pmonta/GNSS_Firehose/enclosure/README

The graphic overlays are in overlays.svg (editable with Inkscape).  Notes:

- designed for the Hammond 1455L1201 enclosure
- layers are provided for:
   * the drawn artwork (inkjet printer or color laser onto polyester self-adhesive media)
   * cut lines (robotic vinyl cutter)
   * bounding boxes
