pmonta/GNSS_Firehose/kicad/graphics/power-symbol.svg.png

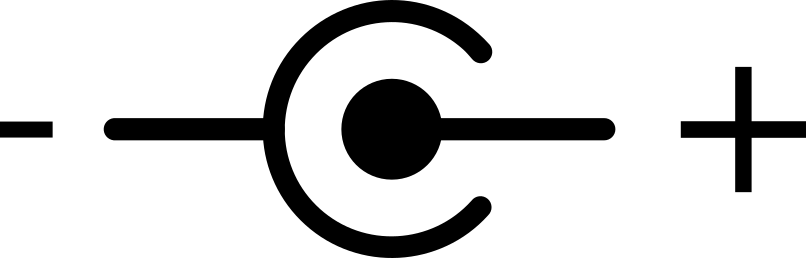
kicad/graphics/power-symbol.svg.png
