pmonta/GNSS_Firehose/enclosure/end_plate_front.step

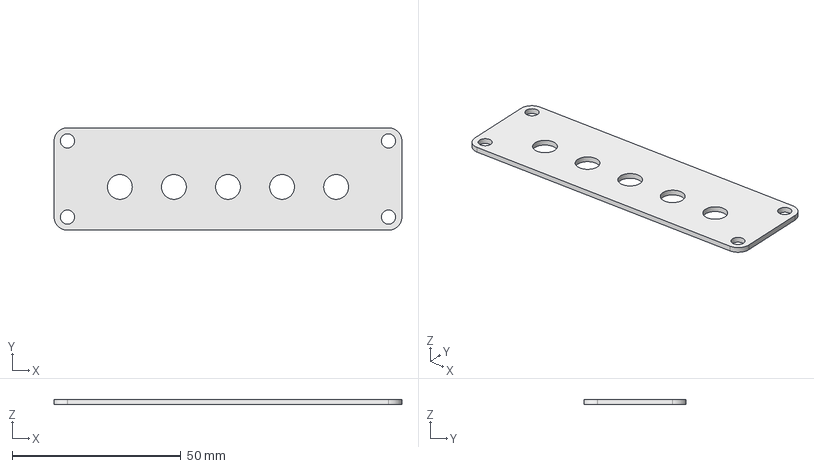
[picture p3: CAD file, 2015-06-21]
enclosure/end_plate_front.step
103.0 x 30.3 x 1.62 mm
