pmonta/GNSS_Firehose/enclosure/tcxo_cap.stl

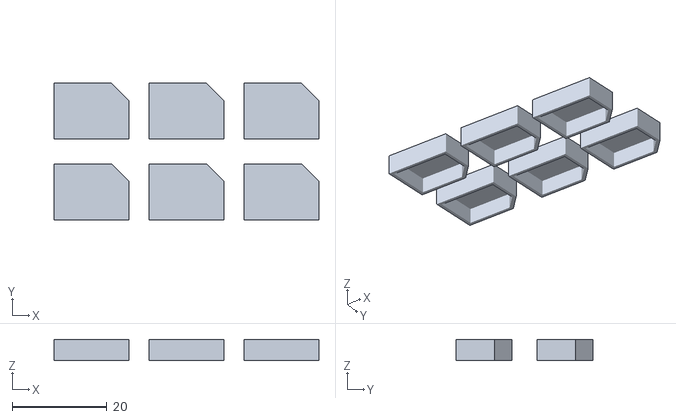
[picture p4: CAD file, 2015-06-09]
enclosure/tcxo_cap.stl
55.8 x 28.8 x 4.50
