pmonta/GNSS_Firehose/(list of files, cad)

Other CAD files:
enclosure/end_plate_back.fcstd
enclosure/end_plate_back.stl
enclosure/end_plate_front.fcstd
enclosure/end_plate_front.stl
