pmonta/GNSS_Firehose/(threads)

Thread 2 (2022-12-02):

AGC control algorithm

jr9910, 2022-12-02:
Hi, I want to know if there are some papers for the AGC control algorithm used in GNSS_Firehose

pmonta, 2022-12-07:
I didn't find too much in the literature about AGC specific to GNSS.  As with any AGC algorithm, it must not be too slow, since tracking some amount of dynamics in gain is desired (for example, temperature-dependent gain in the antenna's LNA, or variation in the Firehose's front-end gain blocks), but it also must not be too fast, to avoid nonlinearities resulting from artificially amplitude-modulating the desired signals.

The scheme in GNSS Firehose is very simple:  integrate a 2-bit histogram over some time interval (a few tens of milliseconds I think).  If the histogram is too narrow (relative to the ideal histogram of Gaussian noise optimally quantized to 2 bits), increase gain by a step, else decrease gain a step.  The steps are quite small, 0.02 dB or so.

If there's a better scheme, I'd be glad to hear about it.  I should probably write a quick "theory of operation" document with these sorts of details in it.  By the way, the Firehose's AGC can be disabled if desired, and a fixed gain applied instead.

Thread 4 (2024-01-29):

Mac M1 and M2 packets dropping

AgileEngineeringLLC, 2024-01-29:
Just a heads-up to others... My Linux boxes work just fine with the Firehose, but both my M1 and M2 macs drop ethernet packets randomly (shows up as IQ values of 0). Appears that the M1 and M2 macs have something wrong in their ethernet firmware or hardware.

pmonta, 2024-03-15:
Might there be options in the macOS networking stack or device drivers to help with this?  Back in the day I remember playing with things like the Linux driver's RX buffer size or interrupt threshold to decrease drops.  Everything has been reliable at default settings of late, though.

By the way, if the dropped packets are single packets only, then the dropout is likely too short in duration to affect the GNSS signal processing.  Large contiguous drops, though, of say more than 100 packets in a row, can start to be a problem.  Each packet's payload has a timestamp inserted by the FPGA, so the packet2wav tool knows when to fill in with zeros; this means the timing of the sample stream emitted by packet2wav is undisturbed by dropped packets, but of course the SNR decreases because of the lost signal.

AgileEngineeringLLC, 2024-03-15:
I researched online and found others having the same issue. I tried several different OS setting changes, but none worked for me. So i gave up trying to use the M2 Mac for recording. The dropped packets were pretty large blocks, and the dropouts occur regularly.
