pmonta/GNSS_Firehose/doc/GNSS_Firehose_schematic_monochrome.pdf

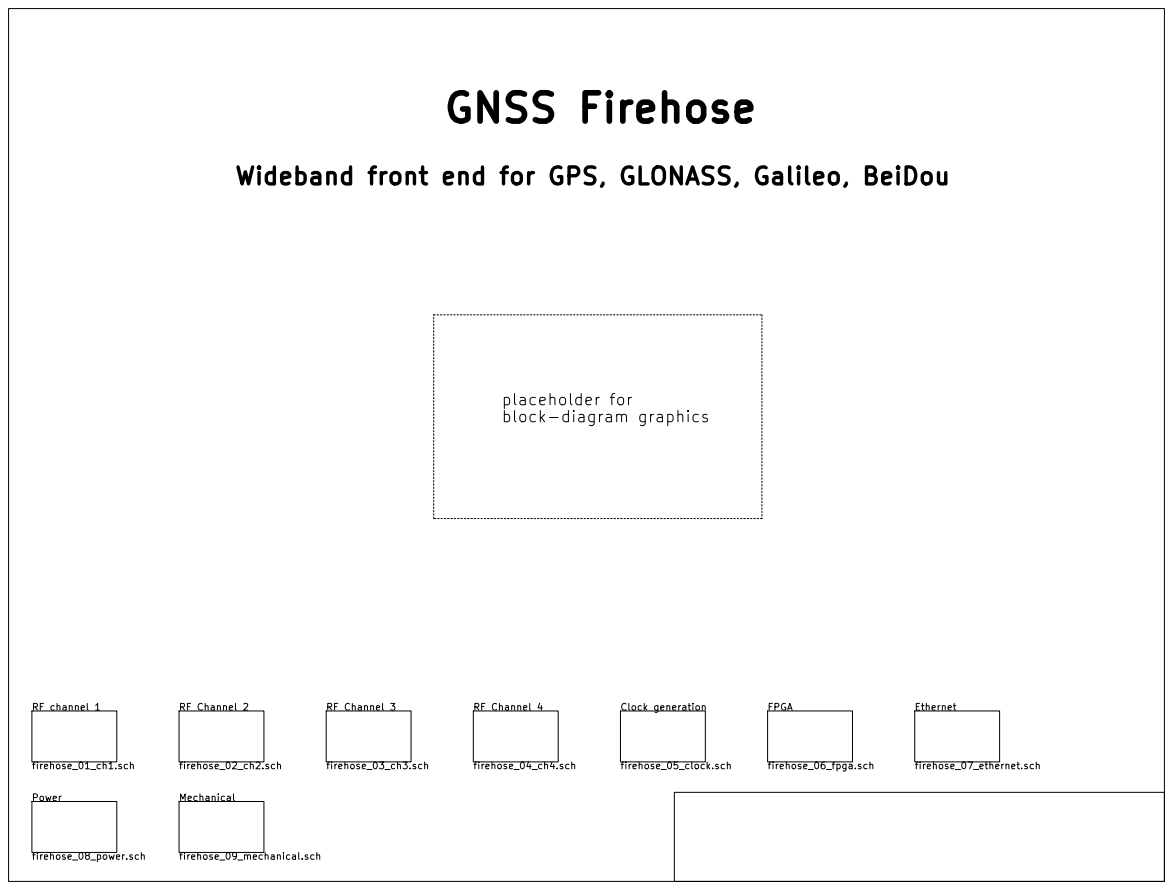
[picture p15: page 1]

Wideband front end for GPS, GLONASS, Galileo, BeiDou

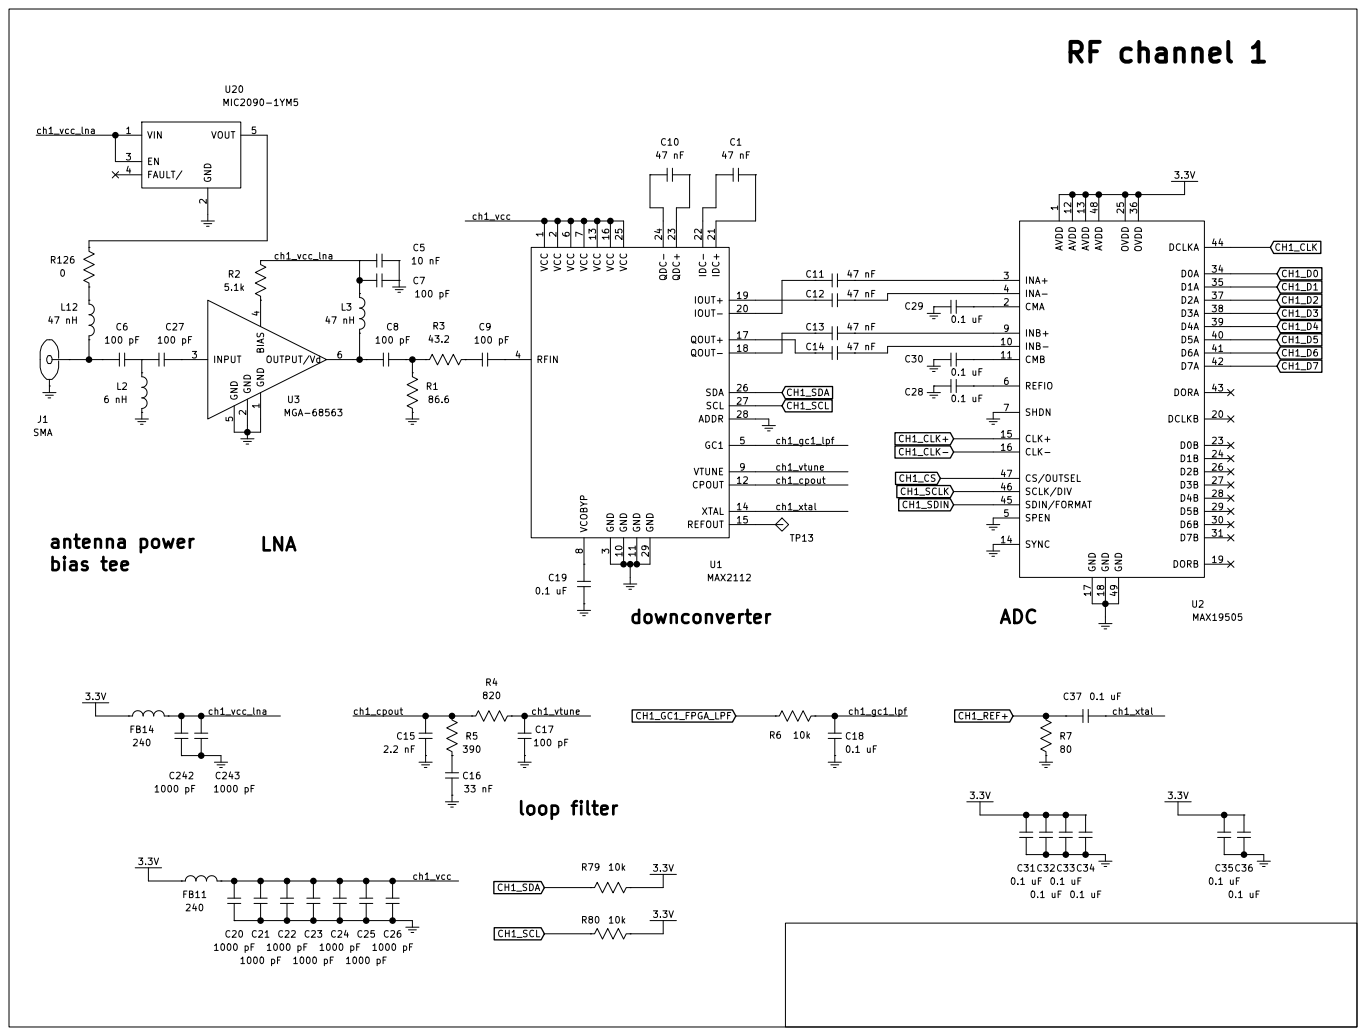
[picture p16: page 2]

5 OUTPUT/Vd 6 U3MGA-68563 RF channel 1
ch1_vcc_lna FB14

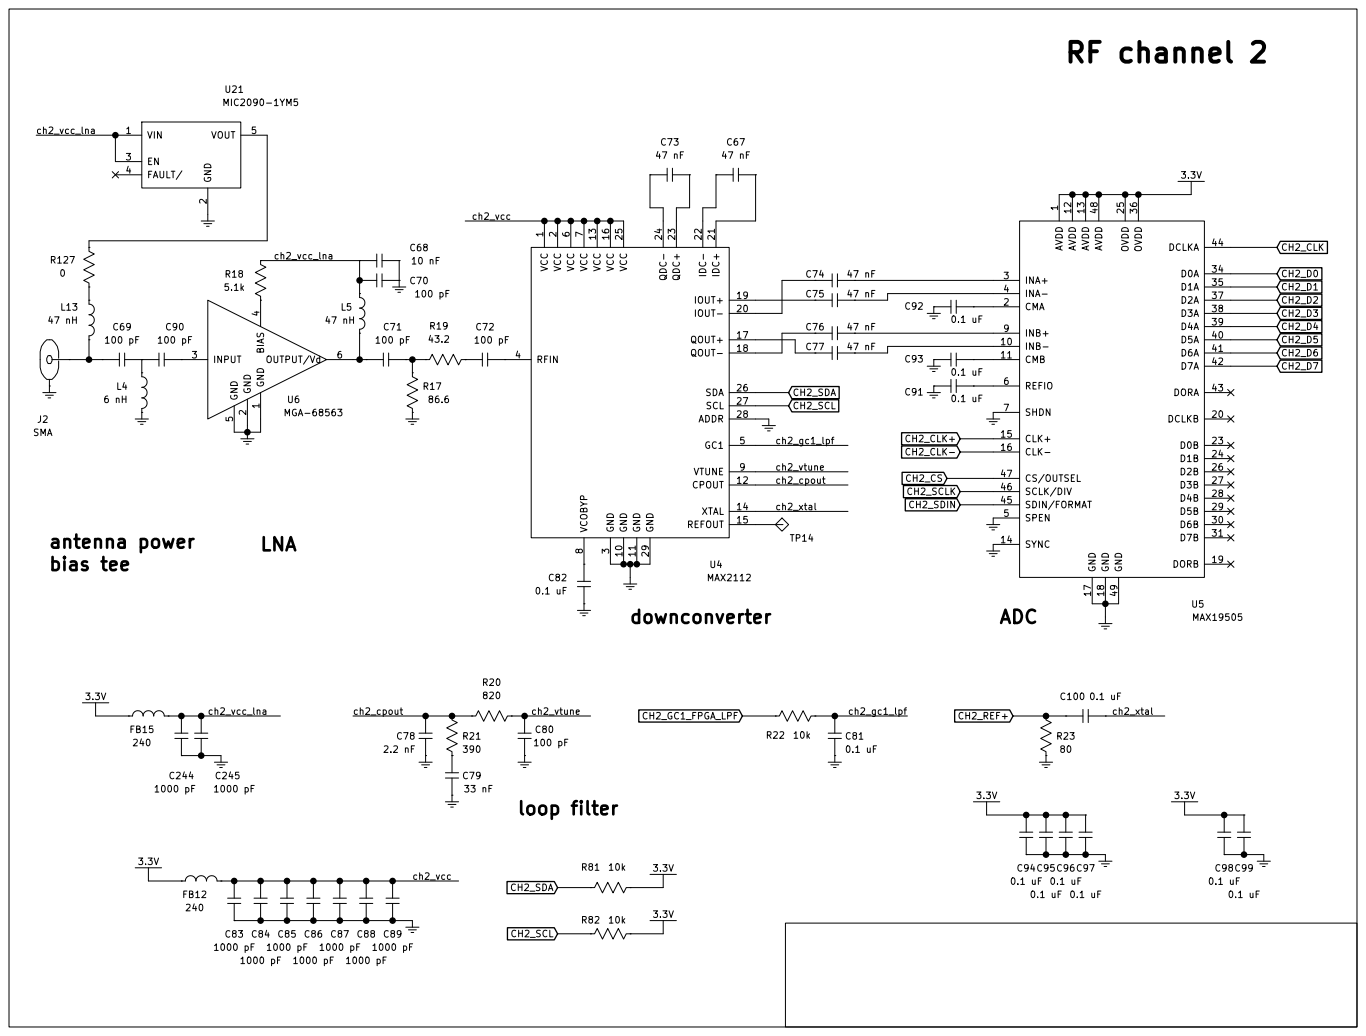
[picture p17: page 3]

5 OUTPUT/Vd 6 U6MGA-68563 RF channel 2
ch2_vcc_lna FB15

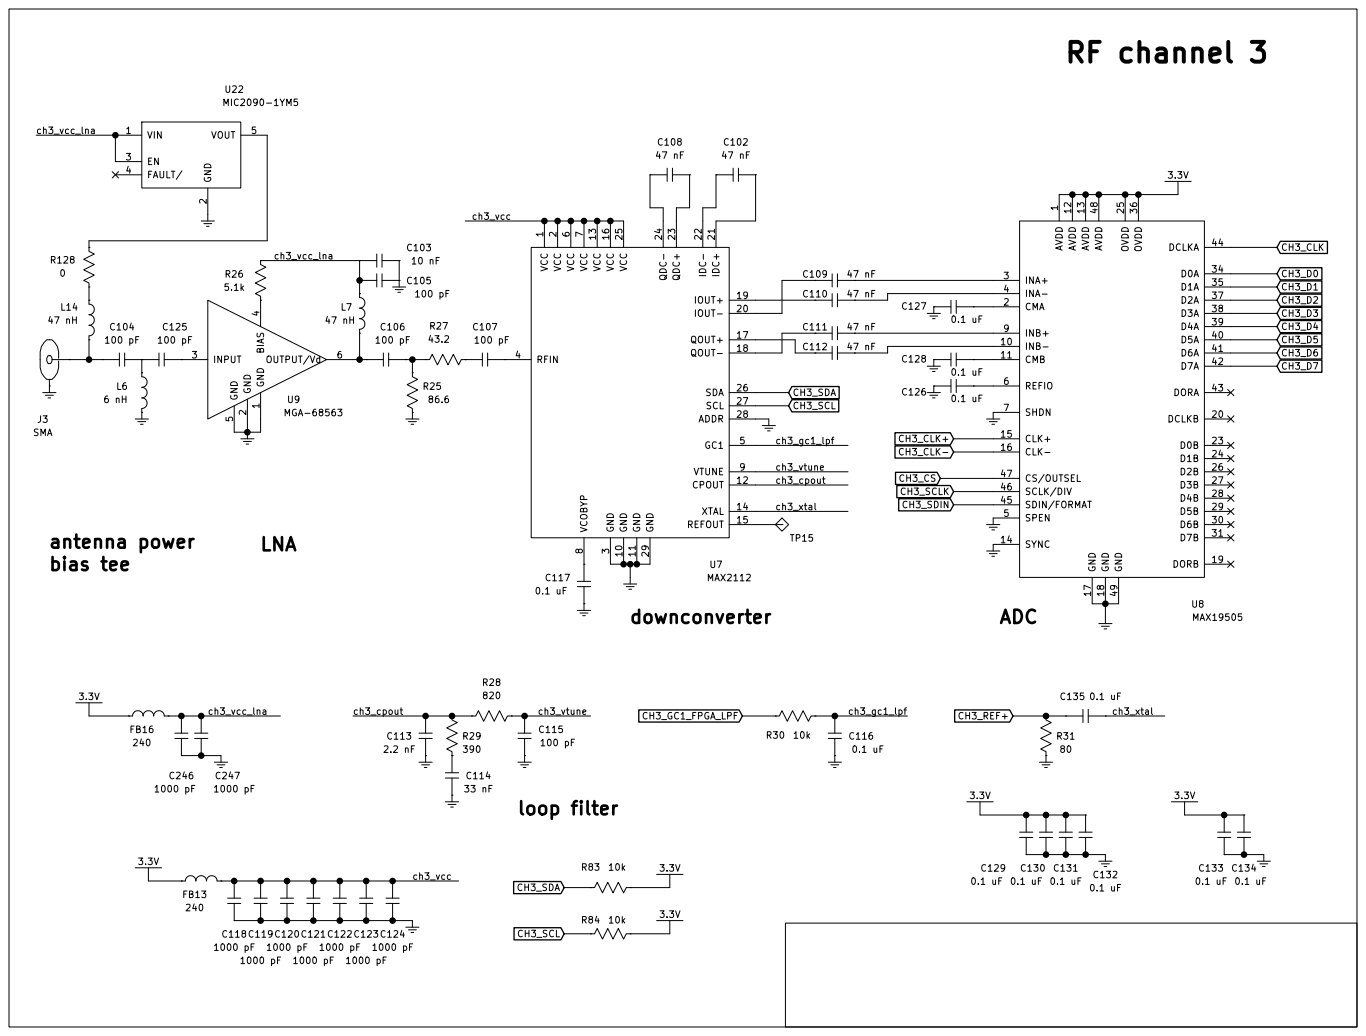
[picture p18: page 4]

5 OUTPUT/Vd 6 U9MGA-68563 RF channel 3
ch3_vcc_lna FB16

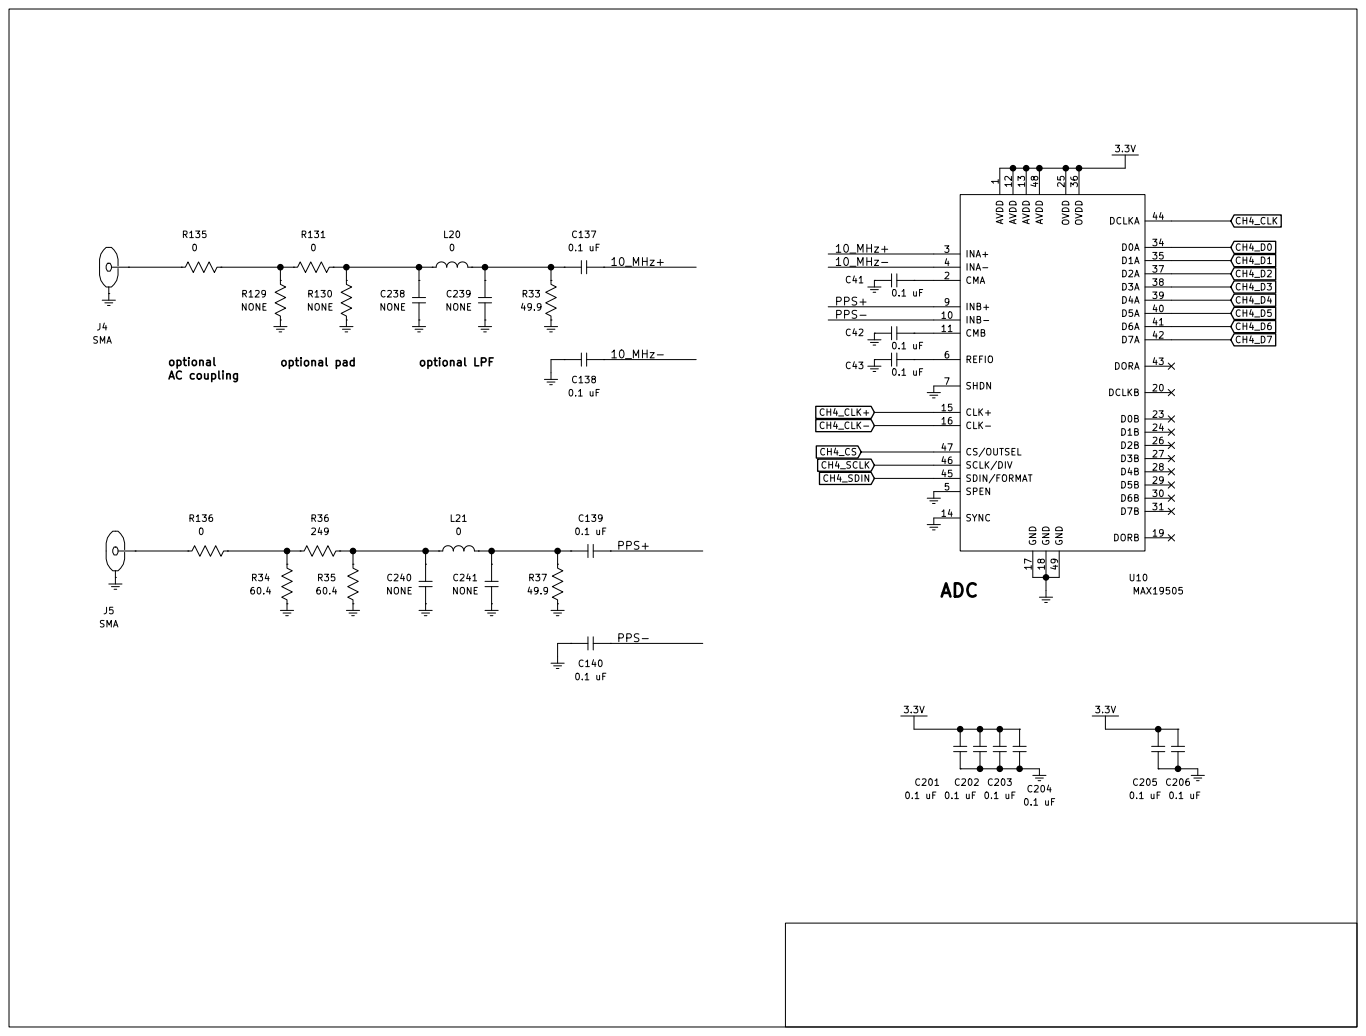
[picture p19: page 5]

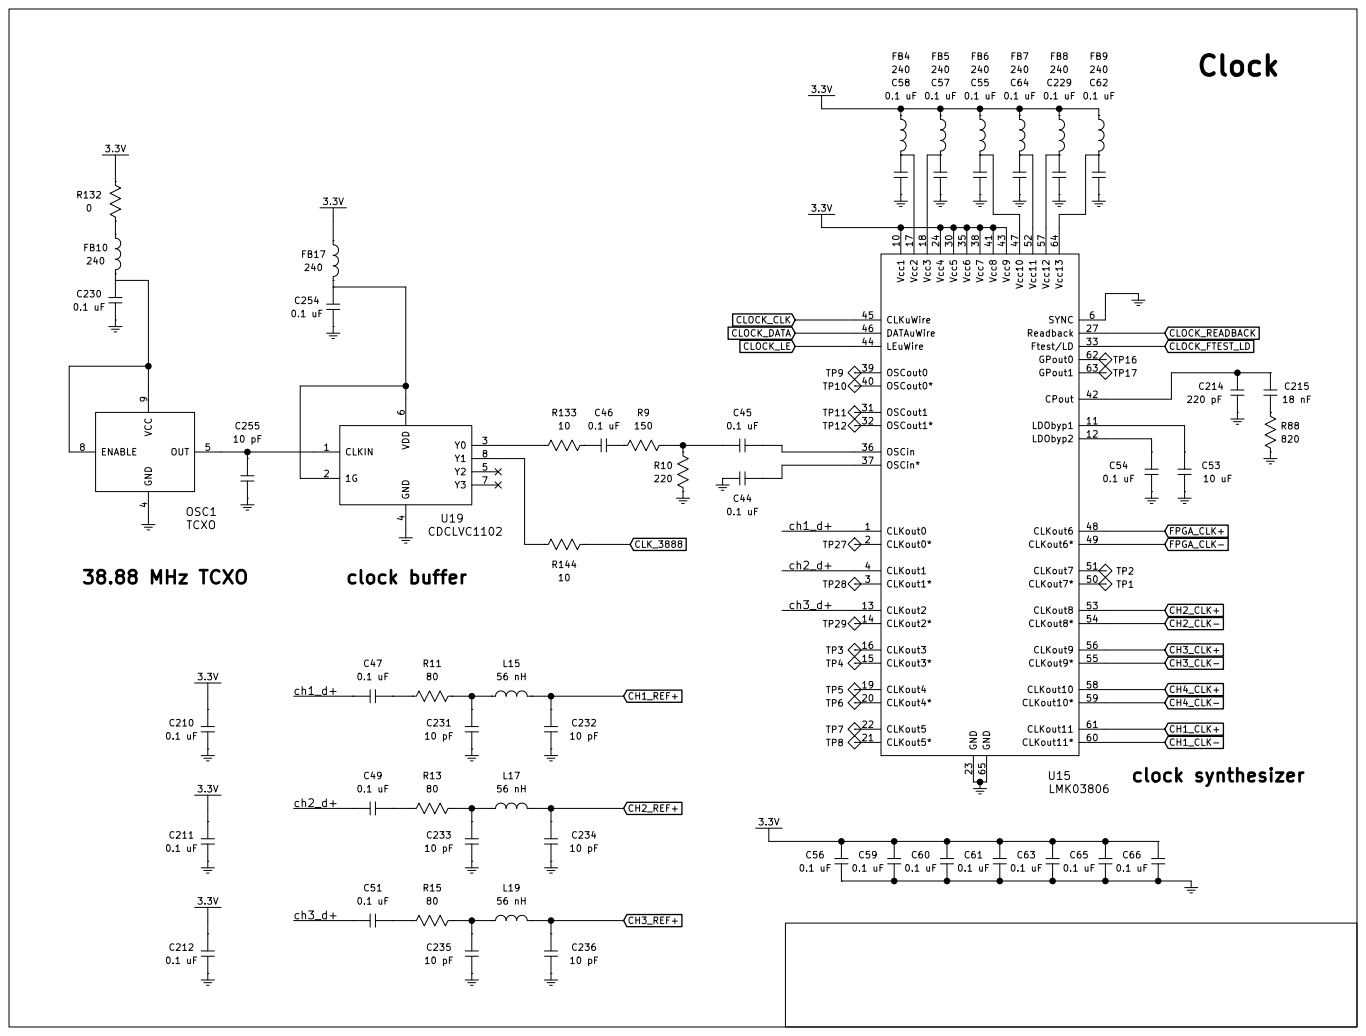
[picture p20: page 6]

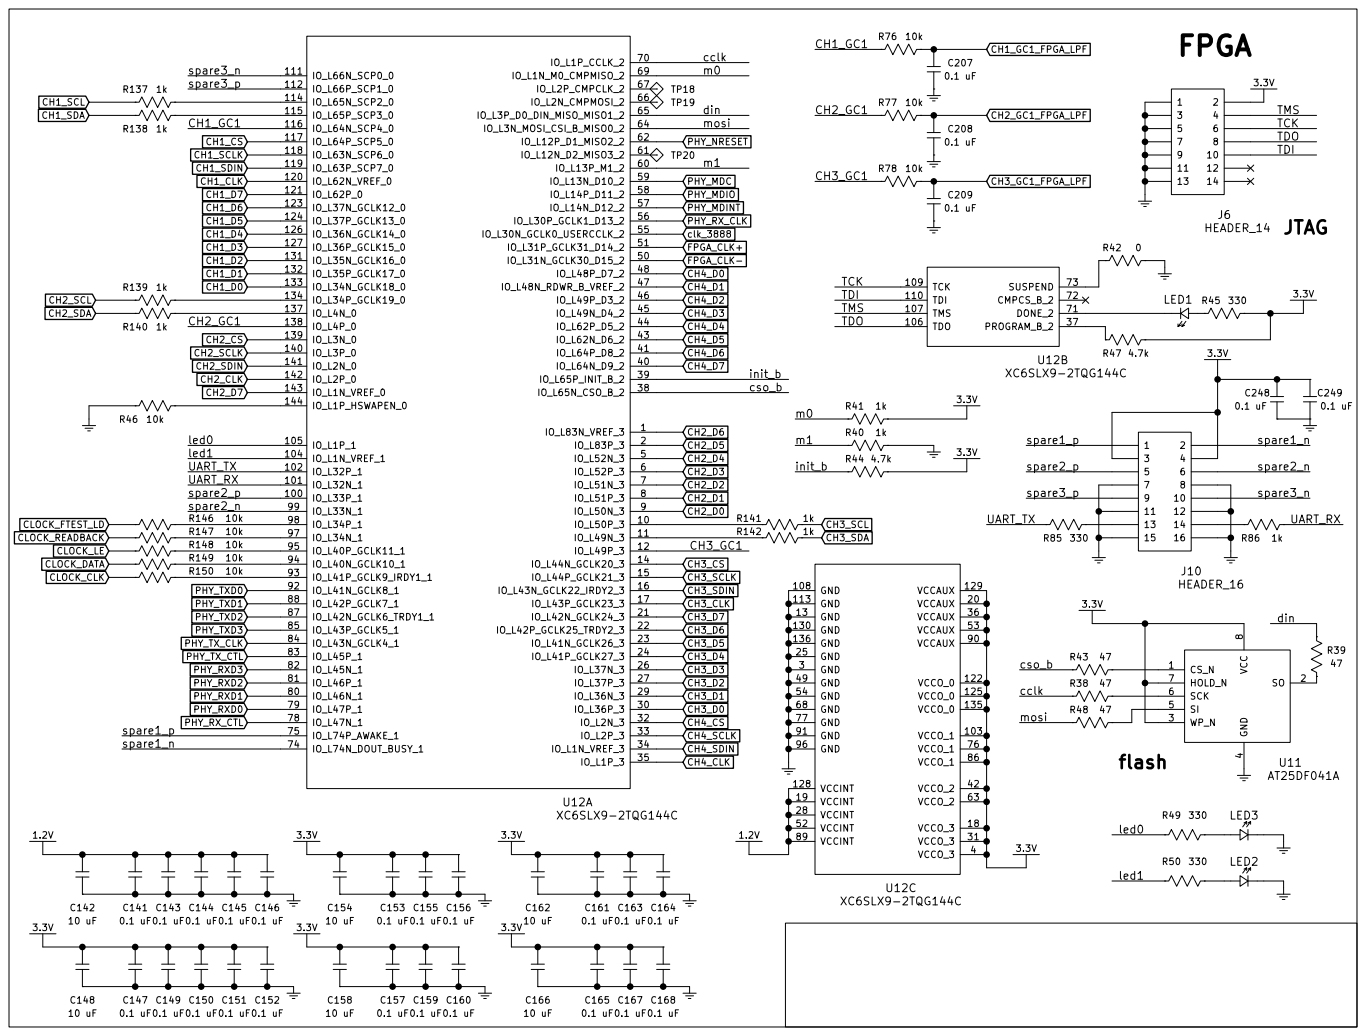
[picture p21: page 7]

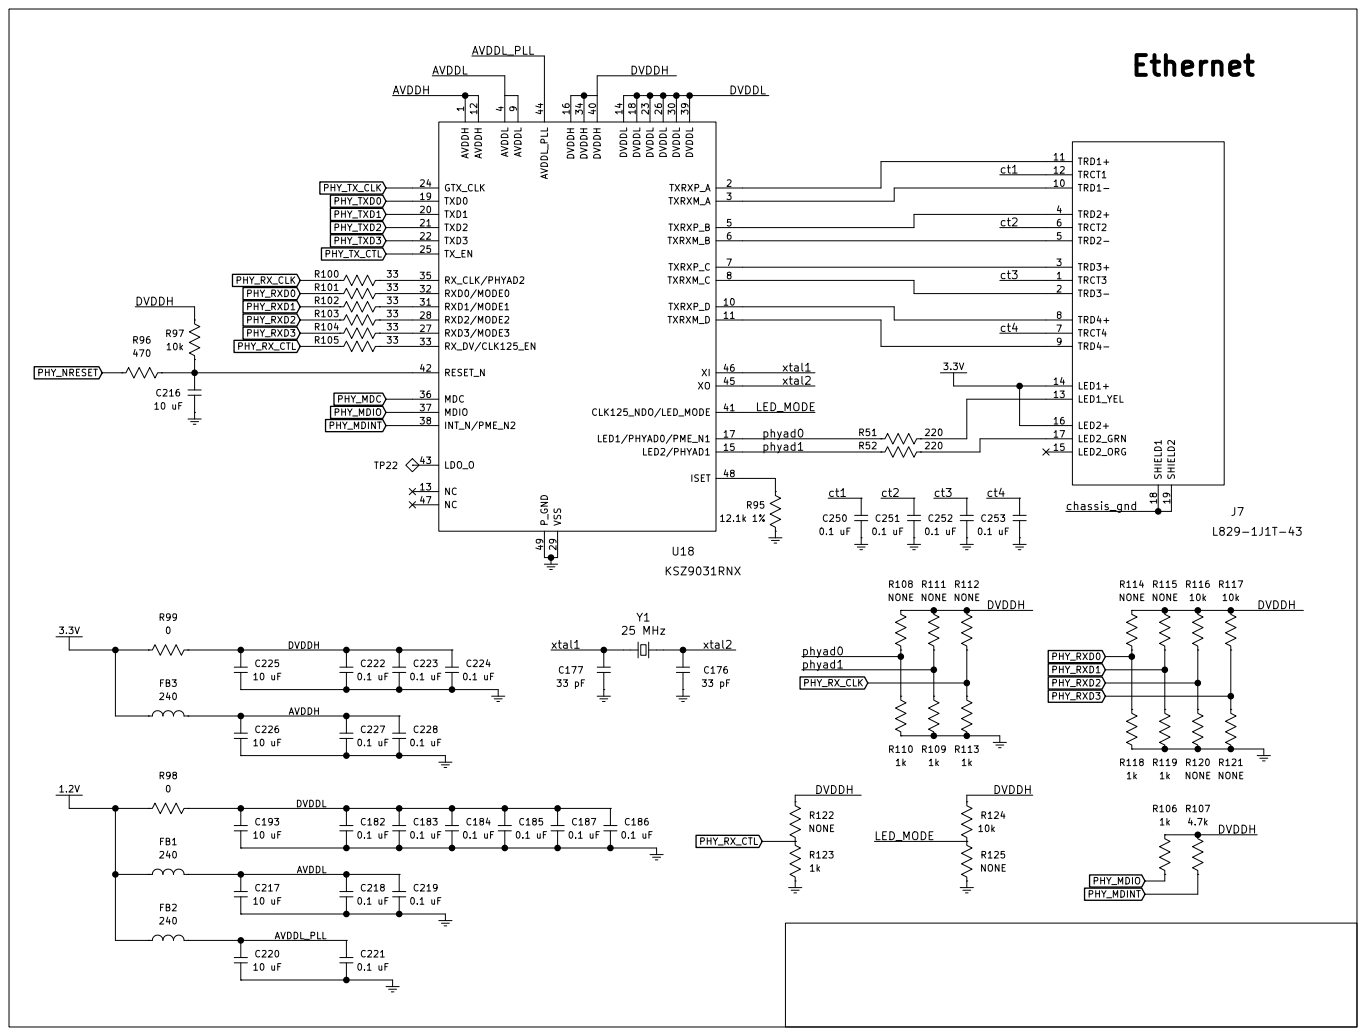
[picture p22: page 8]

9 TXRXP_D 10 TXD1 20 DVDDL 30 DVDDH 40 TXRXM_D 11 TXD2 21 RXD1/MODE1 31 CLK125_NDO/LED_MODE 41 AVDDH 12 TXD3 22 RXD0/MODE0 32 RESET_N 42 NC 13 DVDDL 23 RX_DV/CLK125_EN 33

LED1_YEL 13

LED2+ 16

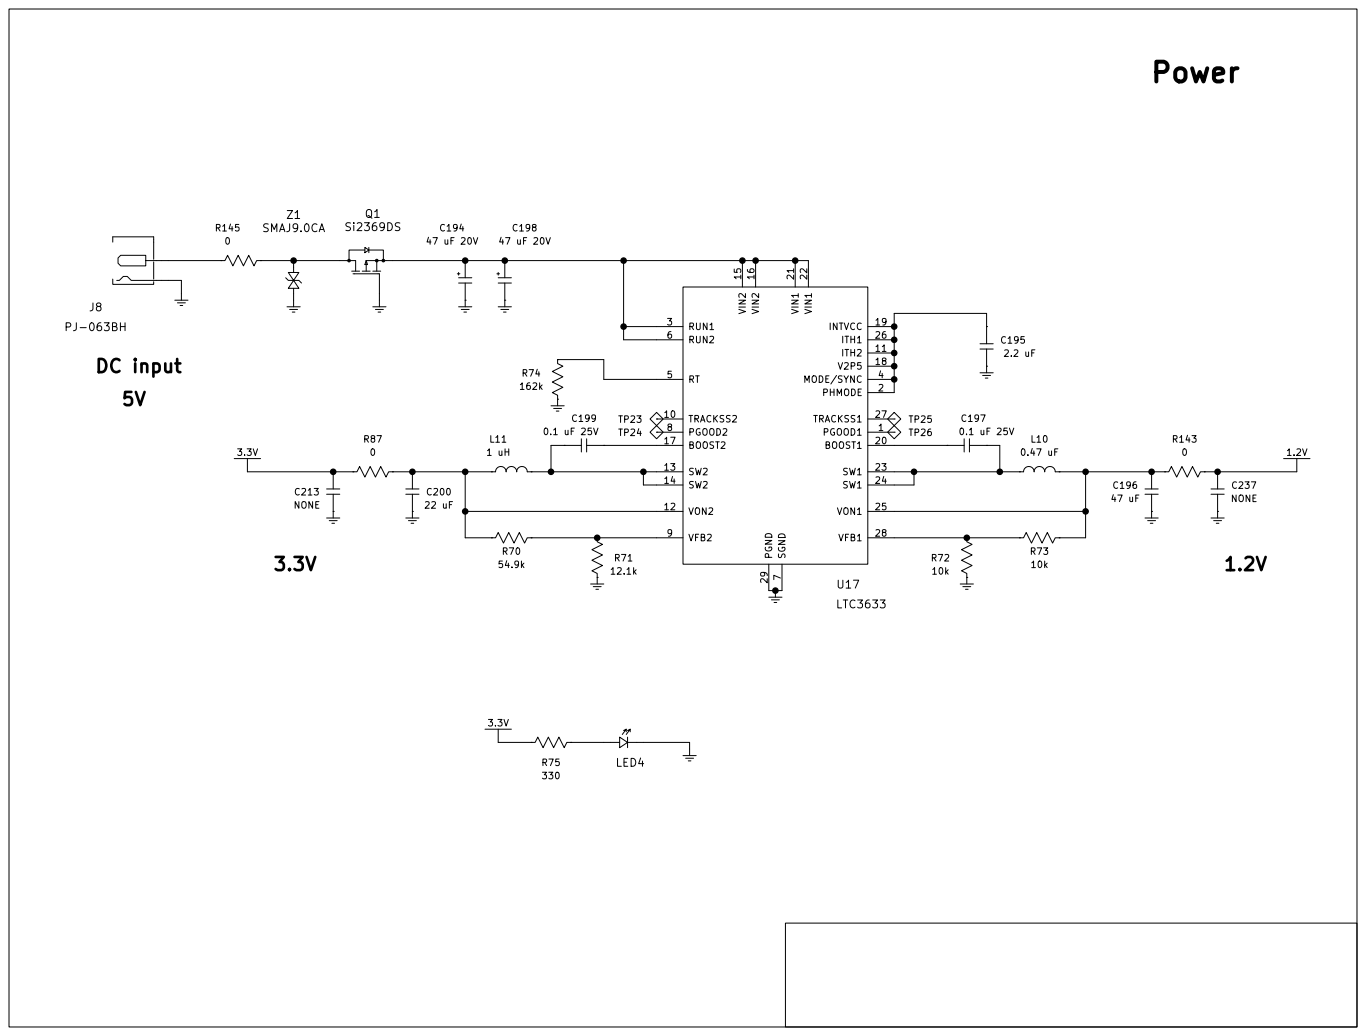
[picture p23: page 9]

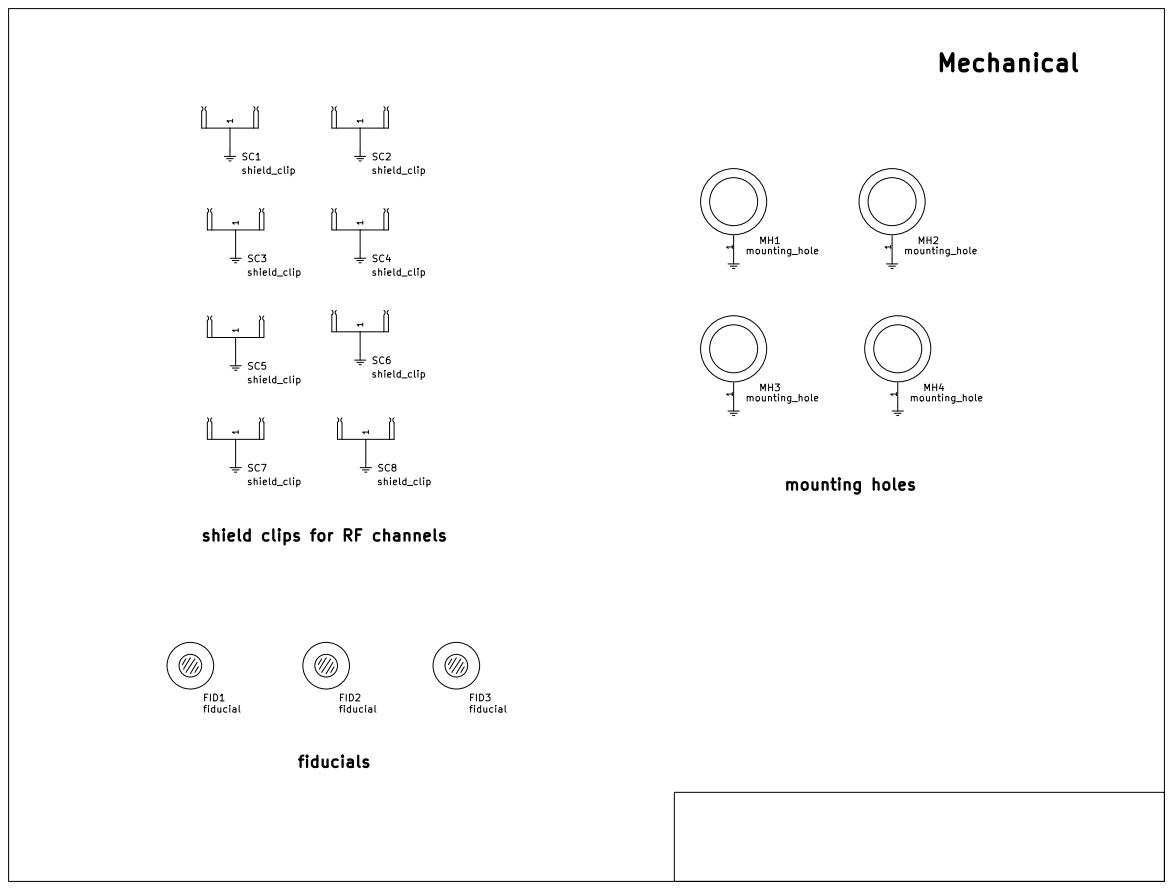
[picture p24: page 10]

shield clips for RF channels
