pmonta/GNSS_Firehose/enclosure/overlays.pdf

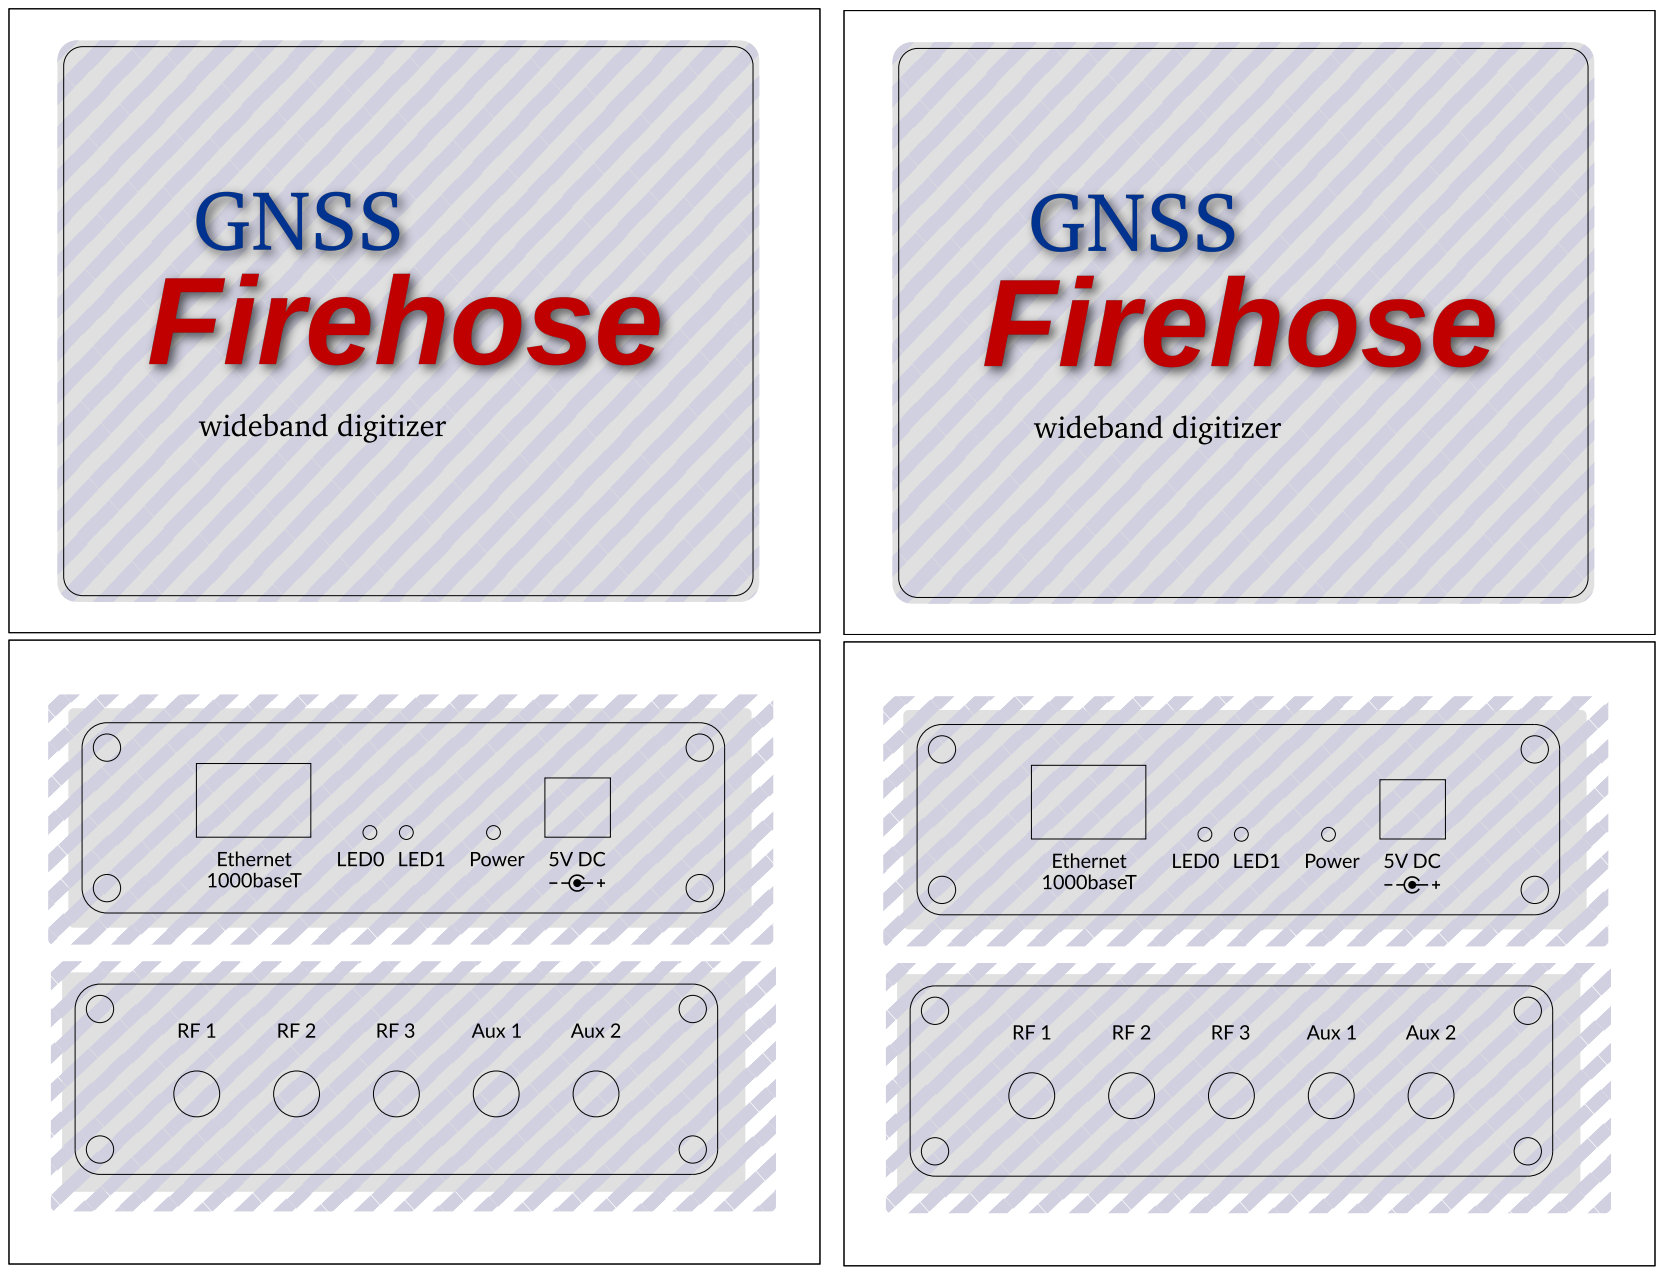
[picture p25: page 1]
