pmonta/GNSS_Firehose/kicad/GNSS_Firehose.kicad_pcb

## KiCad design kicad/GNSS_Firehose.kicad_pcb (2017-04-10)

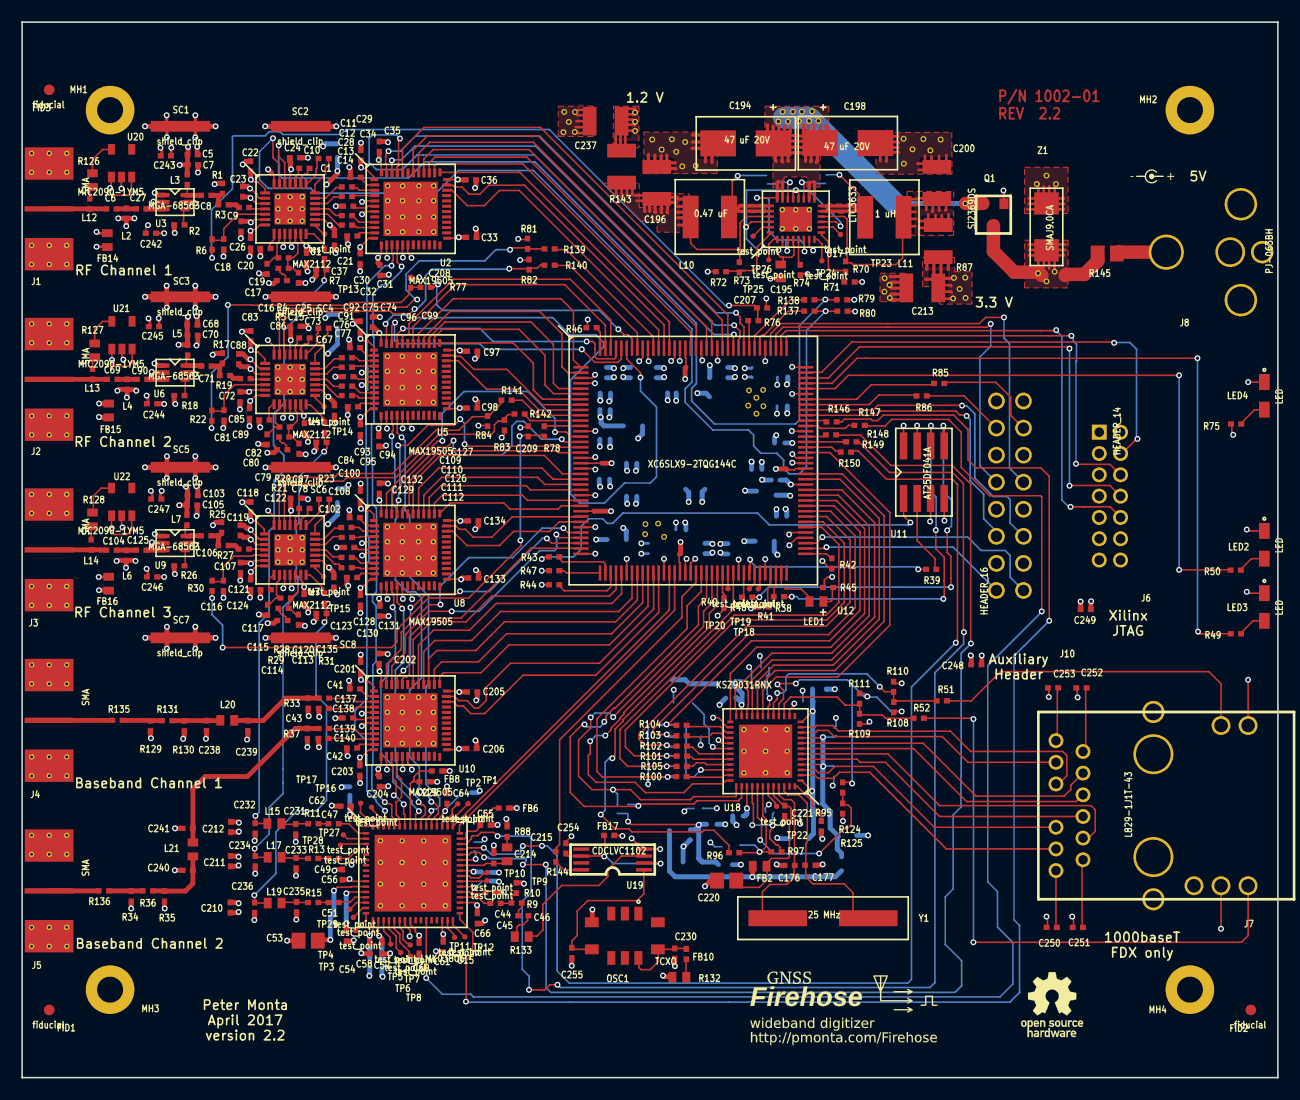
[picture p26: board GNSS_Firehose.kicad_pcb from above]

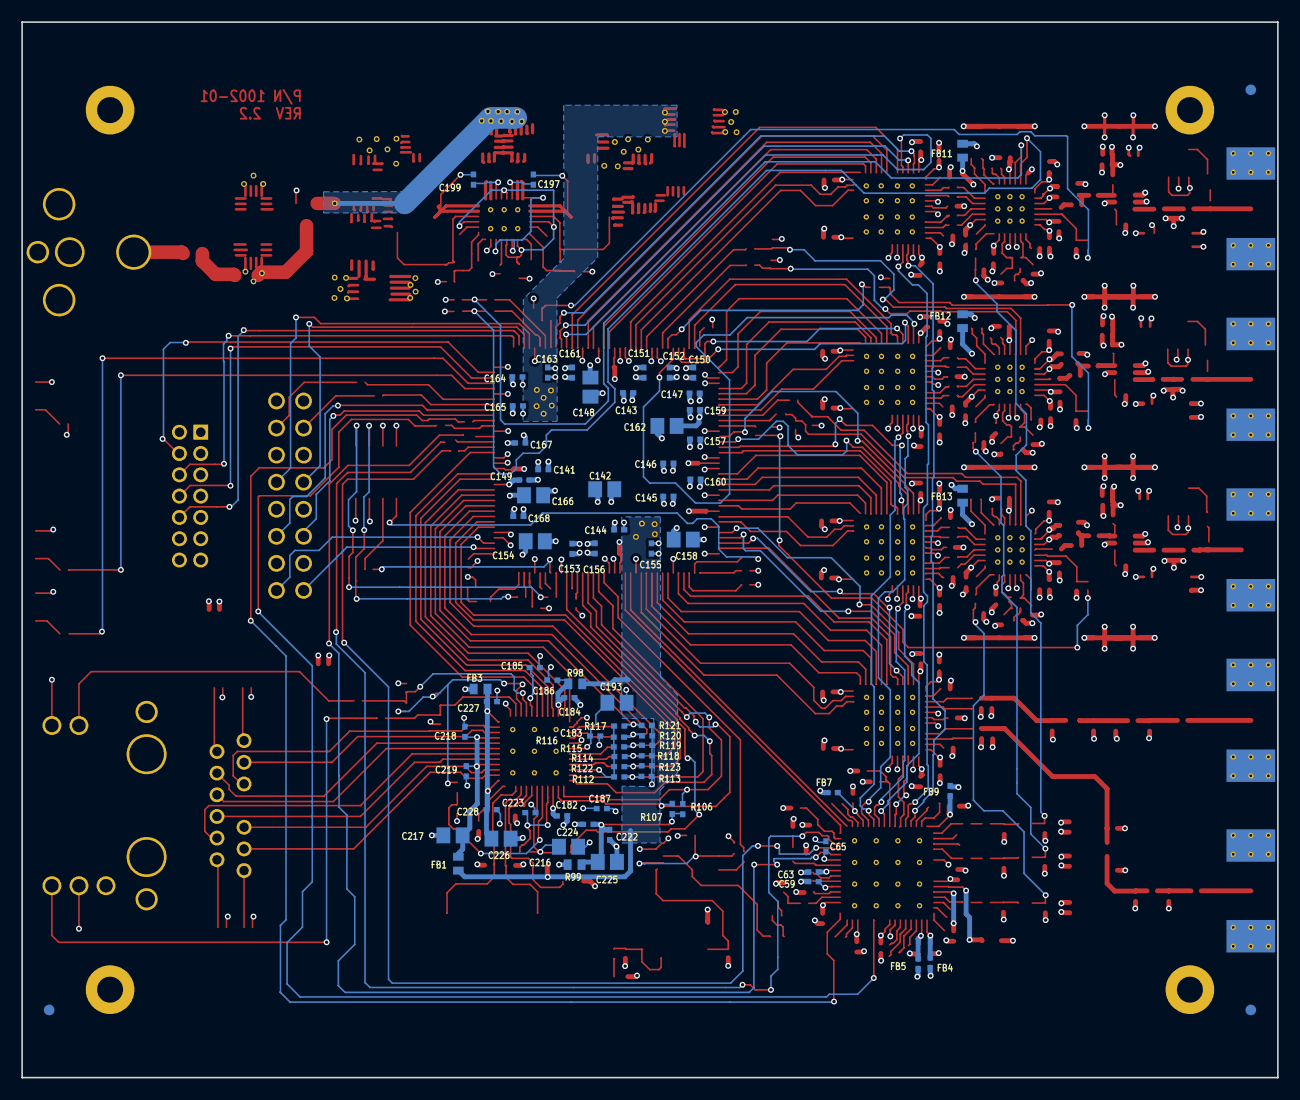
[picture p27: board GNSS_Firehose.kicad_pcb from below]

Board: 4 copper layers, 117.9 x 99.1 mm, 516 parts (76 on the bottom side), 362 nets.

Parts:
C1, C10, C11, C12, C13, C14, C67, C73, C74, C75, C76, C77, C102, C108, C109, C110, C111, C112: 47 nF; 0402
C5, C68, C103: 10 nF; 0402
C6, C7, C8, C9, C17, C27, C69, C70, C71, C72, C80, C90, C104, C105, C106, C107, C115, C125: 100 pF; 0402
C15, C78, C113: 2.2 nF; 0402
C16, C79, C114: 33 nF; 0402
C18, C19, C28, C29, C30, C31, C32, C33, C34, C35, C36, C37, C41, C42, C43, C44, C45, C46, C47, C49, C51, C54, C55, C56, C57, C58, C59, C60, C61, C62, C63, C64, C65, C66, C81, C82, C91, C92, C93, C94, C95, C96, C97, C98, C99, C100, C116, C117, C126, C127, C128, C129, C130, C131, C132, C133, C134, C135, C137, C138, C139, C140, C141, C143, C144, C145, C146, C147, C149, C150, C151, C152, C153, C155, C156, C157, C159, C160, C161, C163, C164, C165, C167, C168, C182, C183, C184, C185, C186, C187, C201, C202, C203, C204, C205, C206, C207, C208, C209, C210, C211, C212, C218, C219, C221, C222, C223, C224, C227, C228, C229, C230, C248, C249, C250, C251, C252, C253, C254: 0.1 uF; 0402
C20, C21, C22, C23, C24, C25, C26, C83, C84, C85, C86, C87, C88, C89, C118, C119, C120, C121, C122, C123, C124, C242, C243, C244, C245, C246, C247: 1000 pF; 0402
C53, C142, C148, C154, C158, C162, C166, C193, C216, C217, C220, C225, C226: 10 uF; 0805
C176, C177: 33 pF; 0402
C194, C198: 47 uF 20V; tantalum-size-D
C195: 2.2 uF; 0603
C196: 47 uF; 1210
C197, C199: 0.1 uF 25V; 0402
C200: 22 uF; 1210
C213, C237: NONE; 1210
C214: 220 pF; 0402
C215: 18 nF; 0603
C231, C232, C233, C234, C235, C236, C255: 10 pF; 0402
C238, C239, C240, C241: NONE; 0402
FB1, FB2, FB3, FB11, FB12, FB13, FB14, FB15, FB16: 240; 0603
FB4, FB5, FB6, FB7, FB8, FB9, FB10, FB17: 240; 0402
FID1, FID2, FID3: fiducial; FIDUCIAL
J1, J2, J3, J4, J5: SMA; SMA_END_LAUNCH
J6: HEADER_14; HEADER14_2MM
J7: L829-1J1T-43
J8: PJ-063BH
J10: HEADER_16; HEADER16_100MIL
L2, L4, L6: 6 nH; 0402
L3, L5, L7, L12, L13, L14: 47 nH; 0402
L10: 0.47 uF; NRS5020
L11: 1 uH; NRS5020
L15, L17, L19: 56 nH; 0603
L20, L21: 0; 0603
LED1: LED; 0603
LED2, LED3, LED4: LED; APA2106
MH1, MH2, MH3, MH4: mounting_hole; HOLE_UNC_2_56
OSC1: TCXO; D75J
Q1: Si2369DS; SOT23
R1, R17, R25: 86.6; 0402
R2, R18, R26: 5.1k; 0402
R3, R19, R27: 43.2; 0402
R4, R20, R28, R88: 820; 0402
R5, R21, R29: 390; 0402
R6, R22, R30, R46, R72, R73, R76, R77, R78, R79, R80, R81, R82, R83, R84, R97, R116, R117, R124, R146, R147, R148, R149, R150: 10k; 0402
R7, R11, R13, R15, R23, R31: 80; 0402
R9: 150; 0402
R10, R51, R52: 220; 0402
R33, R37: 49.9; 0402
R34, R35: 60.4; 0402
R36: 249; 0402
R38, R39, R43, R48: 47; 0402
R40, R41, R86, R106, R109, R110, R113, R118, R119, R123, R137, R138, R139, R140, R141, R142: 1k; 0402
R42, R131, R135, R136: 0; 0402
R44, R47, R107: 4.7k; 0402
R45, R49, R50, R75, R85: 330; 0402
R70: 54.9k; 0402
R71: 12.1k; 0402
R74: 162k; 0402
R87, R143: 0; 1210
R95: 12.1k 1%; 0402
R96: 470; 0402
R98, R99, R126, R127, R128, R132: 0; 0603
R100, R101, R102, R103, R104, R105: 33; 0402
R108, R111, R112, R114, R115, R120, R121, R122, R125, R129, R130: NONE; 0402
R133: 10; 0603
R144: 10; 0402
R145: 0; 0805
SC1, SC2, SC3, SC4, SC5, SC6, SC7, SC8: shield_clip; S1721
TP1, TP2, TP3, TP4, TP5, TP6, TP7, TP8, TP9, TP10, TP11, TP12, TP13, TP14, TP15, TP16, TP17, TP18, TP19, TP20, TP22, TP23, TP24, TP25, TP26, TP27, TP28, TP29: test_point; TP_SMT
U1, U4, U7: MAX2112; QFN28_EP
U2, U5, U8, U10: MAX19505; QFN48_EP
U3, U6, U9: MGA-68563; SOT-363
U11: AT25DF041A; SO8
U12: XC6SLX9-2TQG144C; LQFP144
U15: LMK03806; LLP64_EP
U17: LTC3633; UFD28
U18: KSZ9031RNX; QFN48_EP_MICREL
U19: CDCLVC1102; TSSOP8W
U20, U21, U22: MIC2090-1YM5; SOT-23-5
VIA**: via_12mil
VIA**#2, VIA**#3, VIA**#4, VIA**#5, VIA**#6, VIA**#7, VIA**#8, VIA**#9, VIA**#10, VIA**#11, VIA**#12, VIA**#13, VIA**#14, VIA**#15, VIA**#16, VIA**#17, VIA**#18, VIA**#19, VIA**#20, VIA**#21, VIA**#22, VIA**#23, VIA**#24, VIA**#25, VIA**#26, VIA**#27, VIA**#28, VIA**#29, VIA**#30, VIA**#31, VIA**#32, VIA**#33, VIA**#34, VIA**#35, VIA**#36, VIA**#37, VIA**#38, VIA**#39, VIA**#40, VIA**#41, VIA**#42, VIA**#43, VIA**#44, VIA**#45, VIA**#46, VIA**#47, VIA**#48, VIA**#49, VIA**#50, VIA**#51, VIA**#52, VIA**#53, VIA**#54, VIA**#55, VIA**#56: via_12mil
Y1: 25 MHz; CTS_ATS
Z1: SMAJ9.0CA; SMAJ

Connections:
/Clock generation/ch1_d+: C47.1, U15.1
/Clock generation/ch2_d+: C49.1, U15.4
/Clock generation/ch3_d+: C51.1, U15.13
/Ethernet/AVDDH: C226.1, C227.1, C228.1, FB3.2, U18.1, U18.12
/Ethernet/AVDDL: C217.1, C218.1, C219.1, FB1.2, U18.4, U18.9
/Ethernet/AVDDL_PLL: C220.1, C221.1, FB2.2, U18.44
/Ethernet/DVDDH: C222.1, C223.1, C224.1, C225.1, R97.1, R99.2, R106.1, R107.1, R108.1, R111.1, R112.1, R114.1, R115.1, R116.1, R117.1, R122.1, R124.1, U18.16, U18.34, U18.40
/Ethernet/DVDDL: C182.1, C183.1, C184.1, C185.1, C186.1, C187.1, C193.1, R98.2, U18.14, U18.18, U18.23, U18.26, U18.30, U18.39
/Ethernet/LED_MODE: R124.2, R125.1, U18.41
/Ethernet/chassis_gnd: J7.18, J7.19
/Ethernet/ct1: C250.1, J7.12
/Ethernet/ct2: C251.1, J7.6
/Ethernet/ct3: C252.1, J7.1
/Ethernet/ct4: C253.1, J7.7
/Ethernet/phyad0: R51.1, R108.2, R110.1, U18.17
/Ethernet/phyad1: R52.1, R109.1, R111.2, U18.15
/Ethernet/xtal1: C177.1, U18.46, Y1.1
/Ethernet/xtal2: C176.1, U18.45, Y1.2
/FPGA/CH1_GC1: R76.1, U12.116
/FPGA/CH2_GC1: R77.1, U12.138
/FPGA/CH3_GC1: R78.1, U12.12
/FPGA/TCK: J6.6, U12.109
/FPGA/TDI: J6.10, U12.110
/FPGA/TDO: J6.8, U12.106
/FPGA/TMS: J6.4, U12.107
/FPGA/UART_RX: R86.2, U12.101
/FPGA/UART_TX: R85.1, U12.102
/FPGA/cclk: R38.1, U12.70
/FPGA/cso_b: R43.1, U12.38
/FPGA/din: R39.1, U12.65
/FPGA/init_b: R44.1, U12.39
/FPGA/led0: R49.1, U12.105
/FPGA/led1: R50.1, U12.104
/FPGA/m0: R41.1, U12.69
/FPGA/m1: R40.1, U12.60
/FPGA/mosi: R48.1, U12.64
/FPGA/spare1_n: J10.2, U12.74
/FPGA/spare1_p: J10.1, U12.75
/FPGA/spare2_n: J10.6, U12.99
/FPGA/spare2_p: J10.5, U12.100
/FPGA/spare3_n: J10.10, U12.111
/FPGA/spare3_p: J10.9, U12.112
/RF Channel 2/ch2_cpout: C78.1, R20.2, R21.1, U4.12
/RF Channel 2/ch2_gc1_lpf: C81.1, R22.1, U4.5
/RF Channel 2/ch2_vcc: C83.1, C84.1, C85.1, C86.1, C87.1, C88.1, C89.1, FB12.2, U4.1, U4.2, U4.6, U4.7, U4.13, U4.16, U4.25
/RF Channel 2/ch2_vcc_lna: C68.1, C70.1, C244.1, C245.1, FB15.2, L5.1, R18.1, U21.1, U21.3
/RF Channel 2/ch2_vtune: C80.1, R20.1, U4.9
/RF Channel 2/ch2_xtal: C100.2, U4.14
/RF Channel 3/ch3_cpout: C113.1, R28.2, R29.1, U7.12
/RF Channel 3/ch3_gc1_lpf: C116.1, R30.1, U7.5
/RF Channel 3/ch3_vcc: C118.1, C119.1, C120.1, C121.1, C122.1, C123.1, C124.1, FB13.2, U7.1, U7.2, U7.6, U7.7, U7.13, U7.16, U7.25
/RF Channel 3/ch3_vcc_lna: C103.1, C105.1, C246.1, C247.1, FB16.2, L7.1, R26.1, U22.1, U22.3
/RF Channel 3/ch3_vtune: C115.1, R28.1, U7.9
/RF Channel 3/ch3_xtal: C135.2, U7.14
/RF Channel 4/10_MHz+: C137.2, U10.3
/RF Channel 4/10_MHz-: C138.2, U10.4
/RF Channel 4/PPS+: C139.2, U10.9
/RF Channel 4/PPS-: C140.2, U10.10
/RF channel 1/ch1_cpout: C15.1, R4.2, R5.1, U1.12
/RF channel 1/ch1_gc1_lpf: C18.1, R6.1, U1.5
/RF channel 1/ch1_vcc: C20.1, C21.1, C22.1, C23.1, C24.1, C25.1, C26.1, FB11.2, U1.1, U1.2, U1.6, U1.7, U1.13, U1.16, U1.25
/RF channel 1/ch1_vcc_lna: C5.1, C7.1, C242.1, C243.1, FB14.2, L3.1, R2.1, U20.1, U20.3
/RF channel 1/ch1_vtune: C17.1, R4.1, U1.9
/RF channel 1/ch1_xtal: C37.2, U1.14
CH1_CLK: U2.44, U12.120
CH1_CLK+: U2.15, U15.61
CH1_CLK-: U2.16, U15.60
CH1_CS: U2.47, U12.117
CH1_D0: U2.34, U12.133
CH1_D1: U2.35, U12.132
CH1_D2: U2.37, U12.131
CH1_D3: U2.38, U12.127
CH1_D4: U2.39, U12.126
CH1_D5: U2.40, U12.124
CH1_D6: U2.41, U12.123
CH1_D7: U2.42, U12.121
CH1_GC1_FPGA_LPF: C207.1, R6.2, R76.2
CH1_REF+: C37.1, C232.1, L15.2, R7.1
CH1_SCL: R80.2, R137.1, U1.27
CH1_SCLK: U2.46, U12.118
CH1_SDA: R79.2, R138.1, U1.26
CH1_SDIN: U2.45, U12.119
CH2_CLK: U5.44, U12.142
CH2_CLK+: U5.15, U15.53
CH2_CLK-: U5.16, U15.54
CH2_CS: U5.47, U12.139
CH2_D0: U5.34, U12.9
CH2_D1: U5.35, U12.8
CH2_D2: U5.37, U12.7
CH2_D3: U5.38, U12.6
CH2_D4: U5.39, U12.5
CH2_D5: U5.40, U12.2
CH2_D6: U5.41, U12.1
CH2_D7: U5.42, U12.143
CH2_GC1_FPGA_LPF: C208.1, R22.2, R77.2
CH2_REF+: C100.1, C234.1, L17.2, R23.1
CH2_SCL: R82.2, R139.1, U4.27
CH2_SCLK: U5.46, U12.140
CH2_SDA: R81.2, R140.1, U4.26
CH2_SDIN: U5.45, U12.141
CH3_CLK: U8.44, U12.17
CH3_CLK+: U8.15, U15.56
CH3_CLK-: U8.16, U15.55
CH3_CS: U8.47, U12.14
CH3_D0: U8.34, U12.30
CH3_D1: U8.35, U12.29
CH3_D2: U8.37, U12.27
CH3_D3: U8.38, U12.26
CH3_D4: U8.39, U12.24
CH3_D5: U8.40, U12.23
CH3_D6: U8.41, U12.22
CH3_D7: U8.42, U12.21
CH3_GC1_FPGA_LPF: C209.1, R30.2, R78.2
CH3_REF+: C135.1, C236.1, L19.2, R31.1
CH3_SCL: R84.2, R141.2, U7.27
CH3_SCLK: U8.46, U12.15
CH3_SDA: R83.2, R142.2, U7.26
CH3_SDIN: U8.45, U12.16
CH4_CLK: U10.44, U12.35
CH4_CLK+: U10.15, U15.58
CH4_CLK-: U10.16, U15.59
CH4_CS: U10.47, U12.32
CH4_D0: U10.34, U12.48
CH4_D1: U10.35, U12.47
CH4_D2: U10.37, U12.46
CH4_D3: U10.38, U12.45
CH4_D4: U10.39, U12.44
CH4_D5: U10.40, U12.43
CH4_D6: U10.41, U12.41
CH4_D7: U10.42, U12.40
CH4_SCLK: U10.46, U12.33
CH4_SDIN: U10.45, U12.34
CLK_3888: R144.2, U12.55
CLOCK_CLK: R150.1, U15.45
CLOCK_DATA: R149.1, U15.46
CLOCK_FTEST_LD: R146.1, U15.33
CLOCK_LE: R148.1, U15.44
CLOCK_READBACK: R147.1, U15.27
FPGA_CLK+: U12.51, U15.48
FPGA_CLK-: U12.50, U15.49
GND: C5.2, C7.2, C15.2, C16.2, C17.2, C18.2, C19.2, C20.2, C21.2, C22.2, C23.2, C24.2, C25.2, C26.2, C28.2, C29.2, C30.2, C31.2, C32.2, C33.2, C34.2, C35.2, C36.2, C41.2, C42.2, C43.2, C44.1, C53.2, C54.2, C55.2, C56.2, C57.2, C58.2, C59.2, C60.2, C61.2, C62.2, C63.2, C64.2, C65.2, C66.2, C68.2, C70.2, C78.2, C79.2, C80.2, C81.2, C82.2, C83.2, C84.2, C85.2, C86.2, C87.2, C88.2, C89.2, C91.2, C92.2, C93.2, C94.2, C95.2, C96.2, C97.2, C98.2, C99.2, C103.2, C105.2, C113.2, C114.2, C115.2, C116.2, C117.2, C118.2, C119.2, C120.2, C121.2, C122.2, C123.2, C124.2, C126.2, C127.2, C128.2, C129.2, C130.2, C131.2, C132.2, C133.2, C134.2, C138.1, C140.1, C141.2, C142.2, C143.2, C144.2, C145.2, C146.2, C147.2, C148.2, C149.2, C150.2, C151.2, C152.2, C153.2, C154.2, C155.2, C156.2, C157.2, C158.2, C159.2, C160.2, C161.2, C162.2, C163.2, C164.2, C165.2, C166.2, C167.2, C168.2, C176.2, C177.2, C182.2, C183.2, C184.2, C185.2, C186.2, C187.2, C193.2, C194.2, C195.2, C196.2, C198.2, C200.2, C201.2, C202.2, C203.2, C204.2, C205.2, C206.2, C207.2, C208.2, C209.2, C210.2, C211.2, C212.2, C213.2, C214.2, C216.2, C217.2, C218.2, C219.2, C220.2, C221.2, C222.2, C223.2, C224.2, C225.2, C226.2, C227.2, C228.2, C229.2, C230.2, C231.2, C232.2, C233.2, C234.2, C235.2, C236.2, C237.2, C238.2, C239.2, C240.2, C241.2, C242.2, C243.2, C244.2, C245.2, C246.2, C247.2, C248.2, C249.2, C250.2, C251.2, C252.2, C253.2, C254.2, C255.2, J1.2, J2.2, J3.2, J4.2, J5.2, J6.1, J6.3, J6.5, J6.7, J6.9, J6.11, J6.13, J8.2, J10.7, J10.8, J10.11, J10.12, J10.15, J10.16, L2.2, L4.2, L6.2, LED2.2, LED3.2, LED4.2, MH1.1, MH2.1, MH3.1, MH4.1, OSC1.4, Q1.1, R1.2, R7.2, R10.2, R17.2, R23.2, R25.2, R31.2, R33.2, R34.2, R35.2, R37.2, R40.2, R42.2, R46.1, R71.2, R72.2, R74.2, R88.2, R95.2, R109.2, R110.2, R113.2, R118.2, R119.2, R120.2, R121.2, R123.2, R125.2, R129.2, R130.2, SC1.1, SC2.1, SC3.1, SC4.1, SC5.1, SC6.1, SC7.1, SC8.1, U1.3, U1.10, U1.11, U1.28, U1.29, U2.5, U2.7, U2.14, U2.17, U2.18, U2.49, U3.1, U3.2, U3.5, U4.3, U4.10, U4.11, U4.28, U4.29, U5.5, U5.7, U5.14, U5.17, U5.18, U5.49, U6.1, U6.2, U6.5, U7.3, U7.10, U7.11, U7.28, U7.29, U8.5, U8.7, U8.14, U8.17, U8.18, U8.49, U9.1, U9.2, U9.5, U10.5, U10.7, U10.14, U10.17, U10.18, U10.49, U11.4, U12.3, U12.13, U12.25, U12.49, U12.54, U12.68, U12.77, U12.91, U12.96, U12.108, U12.113, U12.130, U12.136, U15.6, U15.23, U15.65, U17.7, U17.29, U18.29, U18.49, U19.4, U20.2, U21.2, U22.2, VIA**#19.1, VIA**#20.1, VIA**#21.1, VIA**#22.1, VIA**#23.1, VIA**#24.1, VIA**#25.1, VIA**#26.1, VIA**#33.1, VIA**#34.1, VIA**#35.1, VIA**#36.1, VIA**#37.1, VIA**#38.1, VIA**#39.1, VIA**#40.1, VIA**#41.1, VIA**#42.1, VIA**#43.1, VIA**#44.1, VIA**#45.1, VIA**#49.1, VIA**#50.1, VIA**#52.1, VIA**#54.1, Z1.2
unnamed: C1.1, U1.22
unnamed: C1.2, U1.21
unnamed: C6.1, J1.1, L12.2
unnamed: C8.1, L3.2, U3.6
unnamed: C8.2, R1.1, R3.2
unnamed: C9.1, R3.1
unnamed: C9.2, U1.4
unnamed: C10.1, U1.24
unnamed: C10.2, U1.23
unnamed: C11.1, U1.20
unnamed: C11.2, U2.3
unnamed: C12.1, U1.19
unnamed: C12.2, U2.4
unnamed: C13.1, U1.18
unnamed: C13.2, U2.9
unnamed: C14.1, U1.17
unnamed: C14.2, U2.10
unnamed: C16.1, R5.2
unnamed: C19.1, U1.8
unnamed: C6.2, C27.1, L2.1
unnamed: C27.2, U3.3
unnamed: C28.1, U2.6
unnamed: C29.1, U2.2
unnamed: C30.1, U2.11
unnamed: C41.1, U10.2
unnamed: C42.1, U10.11
unnamed: C43.1, U10.6
unnamed: C44.2, U15.37
unnamed: C45.1, R9.2, R10.1
unnamed: C45.2, U15.36
unnamed: C46.1, R133.2
unnamed: C46.2, R9.1
unnamed: C47.2, R11.1
unnamed: C49.2, R13.1
unnamed: C51.2, R15.1
unnamed: C53.1, U15.11
unnamed: C54.1, U15.12
unnamed: C55.1, FB6.2, U15.47
unnamed: C57.1, FB5.2, U15.18
unnamed: C58.1, FB4.2, U15.17
unnamed: C62.1, FB9.2, U15.64
unnamed: C64.1, FB7.2, U15.52
unnamed: C67.1, U4.22
unnamed: C67.2, U4.21
unnamed: C69.1, J2.1, L13.2
unnamed: C69.2, C90.1, L4.1
unnamed: C71.1, L5.2, U6.6
unnamed: C71.2, R17.1, R19.2
unnamed: C72.1, R19.1
unnamed: C72.2, U4.4
unnamed: C73.1, U4.24
unnamed: C73.2, U4.23
unnamed: C74.1, U4.20
unnamed: C74.2, U5.3
unnamed: C75.1, U4.19
unnamed: C75.2, U5.4
unnamed: C76.1, U4.18
unnamed: C76.2, U5.9
unnamed: C77.1, U4.17
unnamed: C77.2, U5.10
unnamed: C79.1, R21.2
unnamed: C82.1, U4.8
unnamed: C90.2, U6.3
unnamed: C91.1, U5.6
unnamed: C92.1, U5.2
unnamed: C93.1, U5.11
unnamed: C102.1, U7.22
unnamed: C102.2, U7.21
unnamed: C104.1, J3.1, L14.2
unnamed: C104.2, C125.1, L6.1
unnamed: C106.1, L7.2, U9.6
unnamed: C106.2, R25.1, R27.2
unnamed: C107.1, R27.1
unnamed: C107.2, U7.4
unnamed: C108.1, U7.24
unnamed: C108.2, U7.23
unnamed: C109.1, U7.20
unnamed: C109.2, U8.3
unnamed: C110.1, U7.19
unnamed: C110.2, U8.4
unnamed: C111.1, U7.18
unnamed: C111.2, U8.9
unnamed: C112.1, U7.17
unnamed: C112.2, U8.10
unnamed: C114.1, R29.2
unnamed: C117.1, U7.8
unnamed: C125.2, U9.3
unnamed: C126.1, U8.6
unnamed: C127.1, U8.2
unnamed: C128.1, U8.11
unnamed: C137.1, C239.1, L20.2, R33.1
unnamed: C139.1, C241.1, L21.2, R37.1
unnamed: C194.1, C198.1, Q1.2, U17.3, U17.6, U17.15, U17.16, U17.21, U17.22, VIA**#9.1, VIA**#10.1, VIA**#11.1, VIA**#12.1, VIA**#13.1, VIA**#14.1, VIA**#15.1, VIA**#16.1, VIA**#46.1, VIA**#51.1
unnamed: C195.1, U17.2, U17.4, U17.11, U17.18, U17.19, U17.26
unnamed: C196.1, L10.2, R73.2, R143.1, U17.25
unnamed: C197.1, L10.1, U17.23, U17.24
unnamed: C197.2, U17.20
unnamed: C199.1, U17.17
unnamed: C199.2, L11.2, U17.13, U17.14
unnamed: C200.1, L11.1, R70.1, R87.2, U17.12
unnamed: C214.1, C215.1, U15.42
unnamed: C215.2, R88.1
unnamed: C216.1, R96.2, R97.2, U18.42
unnamed: C229.1, FB8.2, U15.57
unnamed: C230.1, FB10.2, OSC1.8, OSC1.9
unnamed: C231.1, L15.1, R11.2
unnamed: C233.1, L17.1, R13.2
unnamed: C235.1, L19.1, R15.2
unnamed: C238.1, L20.1, R130.1, R131.2
unnamed: C240.1, L21.1, R35.1, R36.2
unnamed: C254.1, FB17.2, U19.2, U19.6
unnamed: C255.1, OSC1.5, U19.1
unnamed: FB10.1, R132.2
unnamed: J4.1, R135.1
unnamed: J5.1, R136.1
unnamed: J7.2, U18.8
unnamed: J7.3, U18.7
unnamed: J7.4, U18.5
unnamed: J7.5, U18.6
unnamed: J7.8, U18.10
unnamed: J7.9, U18.11
unnamed: J7.10, U18.3
unnamed: J7.11, U18.2
unnamed: J7.13, R51.2
unnamed: J7.17, R52.2
unnamed: J8.1, R145.1
unnamed: J10.13, R85.2
unnamed: J10.14, R86.1
unnamed: L12.1, R126.1
unnamed: L13.1, R127.1
unnamed: L14.1, R128.1
unnamed: LED1.1, R45.1
unnamed: LED1.2, U12.71
unnamed: LED2.1, R50.2
unnamed: LED3.1, R49.2
unnamed: LED4.1, R75.2
unnamed: Q1.3, R145.2, VIA**#31.1, VIA**#32.1, VIA**#47.1, Z1.1
unnamed: R2.2, U3.4
unnamed: R18.2, U6.4
unnamed: R26.2, U9.4
unnamed: R38.2, U11.6
unnamed: R39.2, U11.2
unnamed: R42.1, U12.73
unnamed: R43.2, U11.1
unnamed: R46.2, U12.144
unnamed: R47.1, U12.37
unnamed: R48.2, U11.5
unnamed: R70.2, R71.1, U17.9
unnamed: R72.1, R73.1, U17.28
unnamed: R74.1, U17.5
unnamed: R95.1, U18.48
unnamed: R100.2, U18.35
unnamed: R101.2, U18.32
unnamed: R102.2, U18.31
unnamed: R103.2, U18.28
unnamed: R104.2, U18.27
unnamed: R105.2, U18.33
unnamed: R126.2, U20.5
unnamed: R127.2, U21.5
unnamed: R128.2, U22.5
unnamed: R129.1, R131.1, R135.2
unnamed: R133.1, U19.3
unnamed: R34.1, R36.1, R136.2
unnamed: R137.2, U12.114
unnamed: R138.2, U12.115
unnamed: R139.2, U12.134
unnamed: R140.2, U12.137
unnamed: R141.1, U12.10
unnamed: R142.1, U12.11
unnamed: R144.1, U19.8
unnamed: R146.2, U12.98
unnamed: R147.2, U12.97
unnamed: R148.2, U12.95
unnamed: R149.2, U12.94
unnamed: R150.2, U12.93
unnamed: TP1.1, U15.50
unnamed: TP2.1, U15.51
unnamed: TP3.1, U15.16
unnamed: TP4.1, U15.15
unnamed: TP5.1, U15.19
unnamed: TP6.1, U15.20
unnamed: TP7.1, U15.22
unnamed: TP8.1, U15.21
unnamed: TP9.1, U15.39
unnamed: TP10.1, U15.40
unnamed: TP11.1, U15.31
unnamed: TP12.1, U15.32
unnamed: TP13.1, U1.15
unnamed: TP14.1, U4.15
unnamed: TP15.1, U7.15
unnamed: TP16.1, U15.62
unnamed: TP17.1, U15.63
unnamed: TP18.1, U12.67
unnamed: TP19.1, U12.66
unnamed: TP20.1, U12.61
unnamed: TP22.1, U18.43
unnamed: TP23.1, U17.10
unnamed: TP24.1, U17.8
unnamed: TP25.1, U17.27
unnamed: TP26.1, U17.1
unnamed: TP27.1, U15.2
unnamed: TP28.1, U15.3
unnamed: TP29.1, U15.14
PHY_MDC: U12.59, U18.36
PHY_MDINT: R107.2, U12.57, U18.38
PHY_MDIO: R106.2, U12.58, U18.37
PHY_NRESET: R96.1, U12.62
PHY_RXD0: R101.1, R114.2, R118.1, U12.79
PHY_RXD1: R102.1, R115.2, R119.1, U12.80
PHY_RXD2: R103.1, R116.2, R120.1, U12.81
PHY_RXD3: R104.1, R117.2, R121.1, U12.82
PHY_RX_CLK: R100.1, R112.2, R113.1, U12.56
PHY_RX_CTL: R105.1, R122.2, R123.1, U12.78
PHY_TXD0: U12.92, U18.19
PHY_TXD1: U12.88, U18.20
PHY_TXD2: U12.87, U18.21
PHY_TXD3: U12.85, U18.22
PHY_TX_CLK: U12.84, U18.24
PHY_TX_CTL: U12.83, U18.25
VCC_1.2V: C141.1, C142.1, C143.1, C144.1, C145.1, C146.1, C237.1, FB1.1, FB2.1, R98.1, R143.2, U12.19, U12.28, U12.52, U12.89, U12.128, VIA**.1, VIA**#2.1, VIA**#3.1, VIA**#4.1, VIA**#5.1, VIA**#6.1, VIA**#7.1, VIA**#8.1, VIA**#17.1, VIA**#18.1, VIA**#53.1, VIA**#55.1, VIA**#56.1
VCC_3.3V: C31.1, C32.1, C33.1, C34.1, C35.1, C36.1, C56.1, C59.1, C60.1, C61.1, C63.1, C65.1, C66.1, C94.1, C95.1, C96.1, C97.1, C98.1, C99.1, C129.1, C130.1, C131.1, C132.1, C133.1, C134.1, C147.1, C148.1, C149.1, C150.1, C151.1, C152.1, C153.1, C154.1, C155.1, C156.1, C157.1, C158.1, C159.1, C160.1, C161.1, C162.1, C163.1, C164.1, C165.1, C166.1, C167.1, C168.1, C201.1, C202.1, C203.1, C204.1, C205.1, C206.1, C210.1, C211.1, C212.1, C213.1, C248.1, C249.1, FB3.1, FB4.1, FB5.1, FB6.1, FB7.1, FB8.1, FB9.1, FB11.1, FB12.1, FB13.1, FB14.1, FB15.1, FB16.1, FB17.1, J6.2, J7.14, J7.16, J10.3, J10.4, R41.2, R44.2, R45.2, R47.2, R75.1, R79.1, R80.1, R81.1, R82.1, R83.1, R84.1, R87.1, R99.1, R132.1, U2.1, U2.12, U2.13, U2.25, U2.36, U2.48, U5.1, U5.12, U5.13, U5.25, U5.36, U5.48, U8.1, U8.12, U8.13, U8.25, U8.36, U8.48, U10.1, U10.12, U10.13, U10.25, U10.36, U10.48, U11.3, U11.7, U11.8, U12.4, U12.18, U12.20, U12.31, U12.36, U12.42, U12.53, U12.63, U12.76, U12.86, U12.90, U12.103, U12.122, U12.125, U12.129, U12.135, U15.10, U15.24, U15.30, U15.35, U15.38, U15.41, U15.43, VIA**#27.1, VIA**#28.1, VIA**#29.1, VIA**#30.1, VIA**#48.1
