pmonta/GNSS_Firehose/fpga/xilinx/chip.ucf

# FPGA timing and pin-location constraints
#
# GNSS Firehose
# Copyright (c) 2012 Peter Monta <pmonta@gmail.com>

# Try to follow UG625.
# UG612 covers how to put similar info into a separate .sdc tcl file.
net "clk_adc" tnm_net = "clkADC";
timespec "ts_clkADC" = period "clkADC" 14.5ns;

net "phy_rx_clk" tnm_net = "clkPHYrx";
timespec "ts_clkPHYrx" = period "clkPHYrx" 8ns;

net "clk_3888" tnm_net = "clkTCXO";
timespec "ts_clkTCXO" = period "clkTCXO" 25.72ns;

net "clk125" tnm_net = "clkPHYtx";
timespec "ts_clkPHYtx" = period "clkPHYtx" 8ns;

timegrp "ADC_part" = "clkADC";
timegrp "ETH_part" = "clkPHYtx" "clk125_dcm";
timegrp "CPU_part" = "clkTCXO" EXCEPT "clk125_dcm";

net clk_adc_p loc=p51 | iostandard=lvds_33 | diff_term="true" ;
net clk_adc_n loc=p50 | iostandard=lvds_33 | diff_term="true" ;
net clk_3888 loc=p55 | iostandard=lvcmos33 ;

net ch1_sda loc=p115  | iostandard=lvcmos33 | slew="slow" ;
net ch1_scl loc=p114  | iostandard=lvcmos33 | slew="slow" ;
net ch1_gc1 loc=p116  | iostandard=lvcmos33 | slew="slow" ;
net ch1_cs loc=p117   | iostandard=lvcmos33 | slew="slow" ;
net ch1_sclk loc=p118 | iostandard=lvcmos33 | slew="slow" ;
net ch1_sdin loc=p119 | iostandard=lvcmos33 | slew="slow" ;
net ch1_clk loc=p120  | iostandard=lvcmos33 ;
net ch1_d<0> loc=p133 | iostandard=lvcmos33 ;
net ch1_d<1> loc=p132 | iostandard=lvcmos33 ;
net ch1_d<2> loc=p131 | iostandard=lvcmos33 ;
net ch1_d<3> loc=p127 | iostandard=lvcmos33 ;
net ch1_d<4> loc=p126 | iostandard=lvcmos33 ;
net ch1_d<5> loc=p124 | iostandard=lvcmos33 ;
net ch1_d<6> loc=p123 | iostandard=lvcmos33 ;
net ch1_d<7> loc=p121 | iostandard=lvcmos33 ;

net ch2_sda loc=p137  | iostandard=lvcmos33 | slew="slow" ;
net ch2_scl loc=p134  | iostandard=lvcmos33 | slew="slow" ;
net ch2_gc1 loc=p138  | iostandard=lvcmos33 | slew="slow" ;
net ch2_cs loc=p139   | iostandard=lvcmos33 | slew="slow" ;
net ch2_sclk loc=p140 | iostandard=lvcmos33 | slew="slow" ;
net ch2_sdin loc=p141 | iostandard=lvcmos33 | slew="slow" ;
net ch2_clk loc=p142  | iostandard=lvcmos33 ;
net ch2_d<0> loc=p9   | iostandard=lvcmos33 ;
net ch2_d<1> loc=p8   | iostandard=lvcmos33 ;
net ch2_d<2> loc=p7   | iostandard=lvcmos33 ;
net ch2_d<3> loc=p6   | iostandard=lvcmos33 ;
net ch2_d<4> loc=p5   | iostandard=lvcmos33 ;
net ch2_d<5> loc=p2   | iostandard=lvcmos33 ;
net ch2_d<6> loc=p1   | iostandard=lvcmos33 ;
net ch2_d<7> loc=p143 | iostandard=lvcmos33 ;

net ch3_sda loc=p11   | iostandard=lvcmos33 | slew="slow" ;
net ch3_scl loc=p10   | iostandard=lvcmos33 | slew="slow" ;
net ch3_gc1 loc=p12   | iostandard=lvcmos33 | slew="slow" ;
net ch3_cs loc=p14    | iostandard=lvcmos33 | slew="slow" ;
net ch3_sclk loc=p15  | iostandard=lvcmos33 | slew="slow" ;
net ch3_sdin loc=p16  | iostandard=lvcmos33 | slew="slow" ;
net ch3_clk loc=p17   | iostandard=lvcmos33 ;
net ch3_d<0> loc=p30  | iostandard=lvcmos33 ;
net ch3_d<1> loc=p29  | iostandard=lvcmos33 ;
net ch3_d<2> loc=p27  | iostandard=lvcmos33 ;
net ch3_d<3> loc=p26  | iostandard=lvcmos33 ;
net ch3_d<4> loc=p24  | iostandard=lvcmos33 ;
net ch3_d<5> loc=p23  | iostandard=lvcmos33 ;
net ch3_d<6> loc=p22  | iostandard=lvcmos33 ;
net ch3_d<7> loc=p21  | iostandard=lvcmos33 ;

net ch4_cs loc=p32    | iostandard=lvcmos33 | slew="slow" ;
net ch4_sclk loc=p33  | iostandard=lvcmos33 | slew="slow" ;
net ch4_sdin loc=p34  | iostandard=lvcmos33 | slew="slow" ;
net ch4_clk loc=p35   | iostandard=lvcmos33 ;
net ch4_d<0> loc=p48  | iostandard=lvcmos33 ;
net ch4_d<1> loc=p47  | iostandard=lvcmos33 ;
net ch4_d<2> loc=p46  | iostandard=lvcmos33 ;
net ch4_d<3> loc=p45  | iostandard=lvcmos33 ;
net ch4_d<4> loc=p44  | iostandard=lvcmos33 ;
net ch4_d<5> loc=p43  | iostandard=lvcmos33 ;
net ch4_d<6> loc=p41  | iostandard=lvcmos33 ;
net ch4_d<7> loc=p40  | iostandard=lvcmos33 ;

net phy_tx_clk loc=p84     | iostandard=lvcmos33 ;
net phy_tx_data<0> loc=p92 | iostandard=lvcmos33 ;
net phy_tx_data<1> loc=p88 | iostandard=lvcmos33 ;
net phy_tx_data<2> loc=p87 | iostandard=lvcmos33 ;
net phy_tx_data<3> loc=p85 | iostandard=lvcmos33 ;
net phy_tx_ctl loc=p83     | iostandard=lvcmos33 ;

net phy_rx_clk loc=p56     | iostandard=lvcmos33 ;
net phy_rx_data<0> loc=p79 | iostandard=lvcmos33 ;
net phy_rx_data<1> loc=p80 | iostandard=lvcmos33 ;
net phy_rx_data<2> loc=p81 | iostandard=lvcmos33 ;
net phy_rx_data<3> loc=p82 | iostandard=lvcmos33 ;
net phy_rx_ctl loc=p78     | iostandard=lvcmos33 ;

net phy_mdc loc=p59   | iostandard=lvcmos33 | slew="slow" ;
net phy_mdio loc=p58  | iostandard=lvcmos33 | slew="slow" ;
net phy_mdint loc=p57 | iostandard=lvcmos33 ;
net phy_nreset loc=p62  | iostandard=lvcmos33 | slew="slow" ;

net clock_clk loc=p93      | iostandard=lvcmos33 | slew="slow" ;
net clock_data loc=p94     | iostandard=lvcmos33 | slew="slow" ;
net clock_le loc=p95       | iostandard=lvcmos33 | slew="slow" ;
net clock_readback loc=p97 | iostandard=lvcmos33 ;
net clock_ftest_ld loc=p98 | iostandard=lvcmos33 ;

net uart_rx loc=p101  | iostandard=lvcmos33 ;
net uart_tx loc=p102  | iostandard=lvcmos33 | slew="slow" ;

net led0 loc=p105 | iostandard=lvcmos33 | slew="slow" ;
net led1 loc=p104 | iostandard=lvcmos33 | slew="slow" ;

net spi_cclk  loc=p70 | iostandard=lvcmos33 | slew="slow" ;
net spi_din   loc=p65 | iostandard=lvcmos33 ;
net spi_mosi  loc=p64 | iostandard=lvcmos33 | slew="slow" ;
net spi_cso_b loc=p38 | iostandard=lvcmos33 | slew="slow" ;

# net spare1_p loc=p75  | iostandard=lvcmos33 ;
# net spare1_n loc=p74  | iostandard=lvcmos33 ;
# net spare2_p loc=p100 | iostandard=lvcmos33 ;
# net spare2_n loc=p99  | iostandard=lvcmos33 ;
# net spare3_p loc=p112 | iostandard=lvcmos33 ;
# net spare3_n loc=p111 | iostandard=lvcmos33 ;

# net tp18 loc=p67 | iostandard=lvcmos33 ;
# net tp19 loc=p66 | iostandard=lvcmos33 ;
# net tp20 loc=p61 | iostandard=lvcmos33 ;

# TIG == Timing IGnore
net "*streamer_enable*" tig;
net "*packet_count*" tig;
net "*activity_clk_adc*" tig;
net "*activity_phy_tx_clk*" tig;
net "*mac_addr*" tig;
net "*eth_rx_ready*" tig;
net "*eth_rx_read*" tig;
net "*eth_tx_ready*" tig;
