pmonta/GNSS_Firehose/fpga/hdl/top.v

// Top-level module, technology-independent
//
// GNSS Firehose
// Copyright (c) 2012 Peter Monta <pmonta@gmail.com>

module top(
  input clk_cpu, clk_cpu_reset,
  input clk_adc,

// RF channel 1

  output ch1_sda_t, ch1_scl_t, ch1_gc1,
  input ch1_sda_i, ch1_scl_i,
  output ch1_cs, ch1_sclk,
  input ch1_sdin_i,
  output ch1_sdin_o, ch1_sdin_t,
  input ch1_clk,
  input [15:0] ch1_data,

// RF channel 2

  output ch2_sda_t, ch2_scl_t, ch2_gc1,
  input ch2_sda_i, ch2_scl_i,
  output ch2_cs, ch2_sclk,
  input ch2_sdin_i,
  output ch2_sdin_o, ch2_sdin_t,
  input ch2_clk,
  input [15:0] ch2_data,

// RF channel 3

  output ch3_sda_t, ch3_scl_t, ch3_gc1,
  input ch3_sda_i, ch3_scl_i,
  output ch3_cs, ch3_sclk,
  input ch3_sdin_i,
  output ch3_sdin_o, ch3_sdin_t,
  input ch3_clk,
  input [15:0] ch3_data,

// baseband channel 4

  output ch4_cs, ch4_sclk,
  input ch4_sdin_i,
  output ch4_sdin_o, ch4_sdin_t,
  input ch4_clk,
  input [15:0] ch4_data,

// Ethernet PHY

  input phy_tx_clk,
  output [7:0] phy_tx_mux_data,
  output [1:0] phy_tx_mux_ctl,

  input phy_rx_clk,
  input [7:0] phy_rx_demux_data,
  input [1:0] phy_rx_demux_ctl,

  output phy_mdc,
  input phy_mdio_i,
  output phy_mdio_o, phy_mdio_t,
  input phy_mdint,
  output phy_reset,

// clock chip

  output clock_clk,
  output clock_data,
  output clock_le,
  input clock_readback,
  input clock_ftest_ld,

// debugging UART

  input uart_rx,
  output uart_tx,

// LEDs

  output led0,
  output led1,

// SPI access to flash chip

  output spi_cclk,
  input spi_din,
  output spi_mosi,
  output spi_cso_b,

// DCM control and status

  output dcm_rst,
  input dcm_locked
);

// PWM for gain control pins

  wire [9:0] pwm_ch1, pwm_ch2, pwm_ch3;

  pwm _pwm_ch1(clk_cpu, pwm_ch1, ch1_gc1);
  pwm _pwm_ch2(clk_cpu, pwm_ch2, ch2_gc1);
  pwm _pwm_ch3(clk_cpu, pwm_ch3, ch3_gc1);

// quantizers

  reg [15:0] source_data;
  reg source_en;

  wire source_clk = clk_adc;
  reg source_reset=0;
  always @(posedge source_clk) source_reset <= clk_cpu_reset;

  wire [7:0] ch1_i, ch1_q;
  wire [7:0] ch2_i, ch2_q;
  wire [7:0] ch3_i, ch3_q;
  wire [7:0] ch4_i, ch4_q;

  wire [15:0] ch1_data_binary;
  wire [15:0] ch2_data_binary;
  wire [15:0] ch3_data_binary;
  wire [15:0] ch4_data_binary;

  gray_to_binary _gray0(clk_adc, ch1_data[15:8], ch1_data_binary[15:8]);
  gray_to_binary _gray1(clk_adc, ch1_data[7:0], ch1_data_binary[7:0]);
  gray_to_binary _gray2(clk_adc, ch2_data[15:8], ch2_data_binary[15:8]);
  gray_to_binary _gray3(clk_adc, ch2_data[7:0], ch2_data_binary[7:0]);
  gray_to_binary _gray4(clk_adc, ch3_data[15:8], ch3_data_binary[15:8]);
  gray_to_binary _gray5(clk_adc, ch3_data[7:0], ch3_data_binary[7:0]);
  gray_to_binary _gray6(clk_adc, ch4_data[15:8], ch4_data_binary[15:8]);
  gray_to_binary _gray7(clk_adc, ch4_data[7:0], ch4_data_binary[7:0]);

  assign {ch1_i, ch1_q} = {ch1_data_binary[7:0], ch1_data_binary[15:8]};
  assign {ch2_i, ch2_q} = {ch2_data_binary[7:0], ch2_data_binary[15:8]};
  assign {ch3_i, ch3_q} = {ch3_data_binary[7:0], ch3_data_binary[15:8]};
  assign {ch4_i, ch4_q} = {ch4_data_binary[7:0], ch4_data_binary[15:8]};

  wire [1:0] ch1_si, ch1_sq;
  wire [1:0] ch2_si, ch2_sq;
  wire [1:0] ch3_si, ch3_sq;

  wire [3:0] ch1_s4i, ch1_s4q;
  wire [3:0] ch2_s4i, ch2_s4q;
  wire [3:0] ch3_s4i, ch3_s4q;

  wire [7:0] ch1_i_dc, ch1_q_dc;
  wire [7:0] ch2_i_dc, ch2_q_dc;
  wire [7:0] ch3_i_dc, ch3_q_dc;

// source of random bits for rectangular dither

  wire [63:0] rng;

  rng_n2048_r64_t5_k32_sbfbaac _random(.clk(source_clk), .ce(1'b1), .rng(rng));

  quantize _quantize_ch1_i(source_clk, ch1_i, ch1_i_dc, rng[9:0], ch1_si, ch1_s4i);
  quantize _quantize_ch1_q(source_clk, ch1_q, ch1_q_dc, rng[19:10], ch1_sq, ch1_s4q);
  quantize _quantize_ch2_i(source_clk, ch2_i, ch2_i_dc, rng[29:20], ch2_si, ch2_s4i);
  quantize _quantize_ch2_q(source_clk, ch2_q, ch2_q_dc, rng[39:30], ch2_sq, ch2_s4q);
  quantize _quantize_ch3_i(source_clk, ch3_i, ch3_i_dc, rng[49:40], ch3_si, ch3_s4i);
  quantize _quantize_ch3_q(source_clk, ch3_q, ch3_q_dc, rng[59:50], ch3_sq, ch3_s4q);

  wire [7:0] ch1_hist_0, ch1_hist_1;
  wire [7:0] ch2_hist_0, ch2_hist_1;
  wire [7:0] ch3_hist_0, ch3_hist_1;

  histogram _hist_ch1(source_clk, ch1_si, ch1_hist_0, ch1_hist_1);
  histogram _hist_ch2(source_clk, ch2_si, ch2_hist_0, ch2_hist_1);
  histogram _hist_ch3(source_clk, ch3_si, ch3_hist_0, ch3_hist_1);

  wire [7:0] ch1_i_sum, ch1_q_sum;
  wire [7:0] ch2_i_sum, ch2_q_sum;
  wire [7:0] ch3_i_sum, ch3_q_sum;

  dc_sum _dc_sum1(source_clk, ch1_i, ch1_i_sum);
  dc_sum _dc_sum2(source_clk, ch1_q, ch1_q_sum);
  dc_sum _dc_sum3(source_clk, ch2_i, ch2_i_sum);
  dc_sum _dc_sum4(source_clk, ch2_q, ch2_q_sum);
  dc_sum _dc_sum5(source_clk, ch3_i, ch3_i_sum);
  dc_sum _dc_sum6(source_clk, ch3_q, ch3_q_sum);

  reg [7:0] mode=0;

  reg [7:0] ch1_i_1, ch1_q_1;
  reg [7:0] ch2_i_1, ch2_q_1;
  reg [7:0] ch3_i_1, ch3_q_1;
  reg [7:0] ch4_i_1, ch4_q_1;

  reg [1:0] ch1_si_1, ch1_sq_1;
  reg [1:0] ch2_si_1, ch2_sq_1;
  reg [1:0] ch3_si_1, ch3_sq_1;

  reg [3:0] ch1_s4i_1, ch1_s4q_1;
  reg [3:0] ch2_s4i_1, ch2_s4q_1;
  reg [3:0] ch3_s4i_1, ch3_s4q_1;

  always @(posedge source_clk) begin
    ch1_i_1 <= ch1_i;
    ch1_q_1 <= ch1_q;
    ch2_i_1 <= ch2_i;
    ch2_q_1 <= ch2_q;
    ch3_i_1 <= ch3_i;
    ch3_q_1 <= ch3_q;
    ch4_i_1 <= ch4_i;
    ch4_q_1 <= ch4_q;
    ch1_si_1 <= ch1_si;
    ch1_sq_1 <= ch1_sq;
    ch2_si_1 <= ch2_si;
    ch2_sq_1 <= ch2_sq;
    ch3_si_1 <= ch3_si;
    ch3_sq_1 <= ch3_sq;
    ch1_s4i_1 <= ch1_s4i;
    ch1_s4q_1 <= ch1_s4q;
    ch2_s4i_1 <= ch2_s4i;
    ch2_s4q_1 <= ch2_s4q;
    ch3_s4i_1 <= ch3_s4i;
    ch3_s4q_1 <= ch3_s4q;
  end

  reg [1:0] phase;
  reg [7:0] phase_c;

  always @(posedge source_clk) begin
    phase <= phase + 1;
    if (phase==2'd3)
      phase_c <= (phase_c==8'd239) ? 0 : (phase_c+1);
  end

  reg p_end;
  wire source_packet_end = (phase_c==8'd239) && p_end;

  always @* begin
    p_end = 0;
    case (mode)
      8'd0:
          case (phase)
            2'd0: begin source_en = 1; source_data = {ch1_si_1,ch1_sq_1, ch2_si_1,ch2_sq_1, ch3_si_1,ch3_sq_1, ch1_si,ch1_sq}; end
            2'd1: begin source_en = 1; source_data = {ch2_si_1,ch2_sq_1, ch3_si_1,ch3_sq_1, ch1_si,ch1_sq,     ch2_si,ch2_sq}; end
            2'd2: begin source_en = 1; source_data = {ch3_si_1,ch3_sq_1, ch1_si,ch1_sq,     ch2_si,ch2_sq,     ch3_si,ch3_sq}; p_end = 1; end
            2'd3: begin source_en = 0; source_data = 0; end
          endcase
      8'd1:
          case (phase)
            2'd0: begin source_en = 1; source_data = {ch1_i_1,ch1_i}; end
            2'd1: begin source_en = 0; source_data = 0; end
            2'd2: begin source_en = 1; source_data = {ch1_i_1,ch1_i}; p_end = 1; end
            2'd3: begin source_en = 0; source_data = 0; end
          endcase
      8'd2:
          case (phase)
            2'd0: begin source_en = 1; source_data = {ch1_q_1,ch1_q}; end
            2'd1: begin source_en = 0; source_data = 0; end
            2'd2: begin source_en = 1; source_data = {ch1_q_1,ch1_q}; p_end = 1; end
            2'd3: begin source_en = 0; source_data = 0; end
          endcase
      8'd3:
          case (phase)
            2'd0: begin source_en = 1; source_data = {ch2_i_1,ch2_i}; end
            2'd1: begin source_en = 0; source_data = 0; end
            2'd2: begin source_en = 1; source_data = {ch2_i_1,ch2_i}; p_end = 1; end
            2'd3: begin source_en = 0; source_data = 0; end
          endcase
      8'd4:
          case (phase)
            2'd0: begin source_en = 1; source_data = {ch2_q_1,ch2_q}; end
            2'd1: begin source_en = 0; source_data = 0; end
            2'd2: begin source_en = 1; source_data = {ch2_q_1,ch2_q}; p_end = 1; end
            2'd3: begin source_en = 0; source_data = 0; end
          endcase
      8'd5:
          case (phase)
            2'd0: begin source_en = 1; source_data = {ch3_i_1,ch3_i}; end
            2'd1: begin source_en = 0; source_data = 0; end
            2'd2: begin source_en = 1; source_data = {ch3_i_1,ch3_i}; p_end = 1; end
            2'd3: begin source_en = 0; source_data = 0; end
          endcase
      8'd6:
          case (phase)
            2'd0: begin source_en = 1; source_data = {ch3_q_1,ch3_q}; end
            2'd1: begin source_en = 0; source_data = 0; end
            2'd2: begin source_en = 1; source_data = {ch3_q_1,ch3_q}; p_end = 1; end
            2'd3: begin source_en = 0; source_data = 0; end
          endcase
      8'd7:
          case (phase)
            2'd0: begin source_en = 1; source_data = {ch4_i_1,ch4_i}; end
            2'd1: begin source_en = 0; source_data = 0; end
            2'd2: begin source_en = 1; source_data = {ch4_i_1,ch4_i}; p_end = 1; end
            2'd3: begin source_en = 0; source_data = 0; end
          endcase
      8'd8:
          case (phase)
            2'd0: begin source_en = 1; source_data = {ch4_q_1,ch4_q}; end
            2'd1: begin source_en = 0; source_data = 0; end
            2'd2: begin source_en = 1; source_data = {ch4_q_1,ch4_q}; p_end = 1; end
            2'd3: begin source_en = 0; source_data = 0; end
          endcase
      8'd9:
	  case (phase)
            2'd0: begin source_en = 1; source_data = {ch1_s4i_1,ch1_s4q_1,ch1_s4i,ch1_s4q}; end
            2'd1: begin source_en = 0; source_data = 0; end
            2'd2: begin source_en = 1; source_data = {ch1_s4i_1,ch1_s4q_1,ch1_s4i,ch1_s4q}; p_end = 1; end
            2'd3: begin source_en = 0; source_data = 0; end
          endcase
      8'd10:
	  case (phase)
            2'd0: begin source_en = 1; source_data = {ch2_s4i_1,ch2_s4q_1,ch2_s4i,ch2_s4q}; end
            2'd1: begin source_en = 0; source_data = 0; end
            2'd2: begin source_en = 1; source_data = {ch2_s4i_1,ch2_s4q_1,ch2_s4i,ch2_s4q}; p_end = 1; end
            2'd3: begin source_en = 0; source_data = 0; end
          endcase
      8'd11:
	  case (phase)
            2'd0: begin source_en = 1; source_data = {ch3_s4i_1,ch3_s4q_1,ch3_s4i,ch3_s4q}; end
            2'd1: begin source_en = 0; source_data = 0; end
            2'd2: begin source_en = 1; source_data = {ch3_s4i_1,ch3_s4q_1,ch3_s4i,ch3_s4q}; p_end = 1; end
            2'd3: begin source_en = 0; source_data = 0; end
          endcase
      default:
          begin source_en = 0; source_data = 0; end
    endcase
  end

  (* keep="true" *) wire [15:0] packet_count;

// Ethernet MAC

  (* keep="true" *) reg streamer_enable_x=0;
  (* keep="true" *) wire [47:0] mac_addr;

  wire streamer_enable;
  always @(posedge phy_tx_clk) streamer_enable_x <= streamer_enable;  // CDC

// 64-byte dual-port RAM holding CPU's tx packet

  wire [5:0] eth_tx_waddr;
  wire [7:0] eth_tx_wdata;
  wire eth_tx_we;
  wire eth_tx_ready;

  wire [5:0] cmd_addr;
  wire [7:0] cmd_data;

  dpram_64 _eth_tx_dpram(
    clk_cpu, eth_tx_waddr, eth_tx_wdata, eth_tx_we,
    phy_tx_clk, cmd_addr, cmd_data
  );

  packet_streamer _packet_streamer(
    source_clk, source_reset,
    source_data, source_en, source_packet_end,
    phy_tx_clk, phy_tx_mux_data, phy_tx_mux_ctl,
    packet_count,
    streamer_enable_x,
    mac_addr,
    eth_tx_ready, cmd_addr, cmd_data
  );

// Ethernet receiver for control packets (64 bytes payload)

  wire [5:0] eth_rx_waddr;
  wire [7:0] eth_rx_wdata;
  wire eth_rx_we;

  wire eth_rx_ready;
  wire eth_rx_read;
  reg eth_rx_read_x=0;
  always @(posedge phy_rx_clk) eth_rx_read_x <= eth_rx_read;  // CDC
  wire [5:0] eth_rx_raddr;
  wire [7:0] eth_rx_rdata;

// 64-byte dual-port RAM holding CPU's rx packet

  dpram_64 _eth_rx_dpram(
    phy_rx_clk, eth_rx_waddr, eth_rx_wdata, eth_rx_we,
    clk_cpu, eth_rx_raddr, eth_rx_rdata
  );

  packet_rx _packet_rx(
    phy_rx_clk, phy_rx_demux_data, phy_rx_demux_ctl,
    mac_addr,
    eth_rx_waddr, eth_rx_wdata, eth_rx_we,
    eth_rx_ready, eth_rx_read_x
  );

// clock activity counters

  (* keep="true" *) wire [7:0] activity_clk_adc;
  (* keep="true" *) wire [7:0] activity_phy_tx_clk;
  (* keep="true" *) wire [7:0] activity_phy_rx_clk;

  clock_counter _clk1(clk_adc, activity_clk_adc);
  clock_counter _clk2(phy_tx_clk, activity_phy_tx_clk);
  clock_counter _clk3(phy_rx_clk, activity_phy_rx_clk);

  reg uart_rx_r=0;
  always @(posedge clk_cpu) uart_rx_r <= uart_rx;  // probable IOB

// I/O ports for peripherals

  wire [7:0] out_port_0;  // Clock chip serial link
  wire [7:0] out_port_1;  // loopback testing
  wire [7:0] out_port_2;  // LEDs
  wire [7:0] out_port_4;  // Ethernet PHY SMI bus
  wire [7:0] out_port_6;  // pwm, ch1
  wire [7:0] out_port_7;
  wire [7:0] out_port_8;  // pwm, ch2
  wire [7:0] out_port_9;
  wire [7:0] out_port_10;  // pwm, ch3
  wire [7:0] out_port_11;
  wire [7:0] out_port_12;  // SPI, ch1
  wire [7:0] out_port_13;  // SPI, ch2
  wire [7:0] out_port_14;  // SPI, ch3
  wire [7:0] out_port_15;  // SPI, ch4
  wire [7:0] out_port_17;  // I2C, ch1
  wire [7:0] out_port_18;  // I2C, ch2
  wire [7:0] out_port_19;  // I2C, ch3
  wire [7:0] out_port_20;  // PHY reset
  wire [7:0] out_port_21;  // packet streamer control
  wire [7:0] out_port_22;  // ch1_i DC correction
  wire [7:0] out_port_23;  // ch1_q DC correction
  wire [7:0] out_port_24;  // ch2_i DC correction
  wire [7:0] out_port_25;  // ch2_q DC correction
  wire [7:0] out_port_26;  // ch3_i DC correction
  wire [7:0] out_port_27;  // ch3_q DC correction
  wire [7:0] out_port_30;  // DCM reset
  wire [7:0] out_port_31;  // SPI flash
  wire [7:0] out_port_40;  // Ethernet MAC address
  wire [7:0] out_port_41;
  wire [7:0] out_port_42;
  wire [7:0] out_port_43;
  wire [7:0] out_port_44;
  wire [7:0] out_port_45;
  wire [7:0] out_port_47;  // sampling mode

  assign {clock_clk,clock_data,clock_le} = out_port_0[2:0];
  assign led1 = out_port_2[0];
  assign {phy_mdc,phy_mdio_o,phy_mdio_t} = out_port_4[2:0];
  assign pwm_ch1 = {out_port_7[1:0],out_port_6};
  assign pwm_ch2 = {out_port_9[1:0],out_port_8};
  assign pwm_ch3 = {out_port_11[1:0],out_port_10};
  assign {ch1_cs,ch1_sclk,ch1_sdin_o,ch1_sdin_t} = out_port_12;
  assign {ch2_cs,ch2_sclk,ch2_sdin_o,ch2_sdin_t} = out_port_13;
  assign {ch3_cs,ch3_sclk,ch3_sdin_o,ch3_sdin_t} = out_port_14;
  assign {ch4_cs,ch4_sclk,ch4_sdin_o,ch4_sdin_t} = out_port_15;
  assign {ch1_sda_t,ch1_scl_t} = out_port_17;
  assign {ch2_sda_t,ch2_scl_t} = out_port_18;
  assign {ch3_sda_t,ch3_scl_t} = out_port_19;
  assign phy_reset = out_port_20[0];
  assign streamer_enable = out_port_21[0];
  assign ch1_i_dc = out_port_22;
  assign ch1_q_dc = out_port_23;
  assign ch2_i_dc = out_port_24;
  assign ch2_q_dc = out_port_25;
  assign ch3_i_dc = out_port_26;
  assign ch3_q_dc = out_port_27;
  assign dcm_rst = out_port_30[0];
  assign {spi_cclk,spi_mosi,spi_cso_b} = out_port_31[2:0];
  assign mac_addr = {out_port_40,out_port_41,out_port_42,out_port_43,out_port_44,out_port_45};
  always @(posedge clk_adc) mode <= out_port_47;

  wire [7:0] in_port_0;  // clock chip readback and lock status
  wire [7:0] in_port_1;  // loopback testing
  wire [7:0] in_port_2;  // PHY SMI bus
  wire [7:0] in_port_5;  // I2C and SPI, ch1
  wire [7:0] in_port_6;  // I2C and SPI, ch2
  wire [7:0] in_port_7;  // I2C and SPI, ch3
  wire [7:0] in_port_8;  // SPI, ch4
  wire [7:0] in_port_17; // I2C readback
  wire [7:0] in_port_18; // I2C readback
  wire [7:0] in_port_19; // I2C readback
  wire [7:0] in_port_20; // histogram readback, ch1
  wire [7:0] in_port_21;
  wire [7:0] in_port_22; // histogram readback, ch2
  wire [7:0] in_port_23;
  wire [7:0] in_port_24; // histogram readback, ch3
  wire [7:0] in_port_25;
  wire [7:0] in_port_26; // packet count
  wire [7:0] in_port_27;
  wire [7:0] in_port_28; // clock activity counter, clk_adc
  wire [7:0] in_port_30; // clock activity counter, phy_tx_clk
  wire [7:0] in_port_31; // clock activity counter, phy_rx_clk
  wire [7:0] in_port_35; // DC sum of ch1_i
  wire [7:0] in_port_36; // DC sum of ch1_q
  wire [7:0] in_port_37; // DC sum of ch2_i
  wire [7:0] in_port_38; // DC sum of ch2_q
  wire [7:0] in_port_39; // DC sum of ch3_i
  wire [7:0] in_port_40; // DC sum of ch3_q
  wire [7:0] in_port_43; // DCM locked
  wire [7:0] in_port_48; // SPI flash

  assign in_port_0 = {6'd0,clock_readback,clock_ftest_ld};
  assign in_port_1 = out_port_1;
  assign in_port_2 = {6'd0,phy_mdio_i,phy_mdint};
  assign in_port_5 = {ch1_sda_i,ch1_scl_i,ch1_sdin_i};
  assign in_port_6 = {ch2_sda_i,ch2_scl_i,ch2_sdin_i};
  assign in_port_7 = {ch3_sda_i,ch3_scl_i,ch3_sdin_i};
  assign in_port_8 = {ch4_sdin_i};
  assign in_port_17 = {ch1_sda_t,ch1_scl_t};
  assign in_port_18 = {ch2_sda_t,ch2_scl_t};
  assign in_port_19 = {ch3_sda_t,ch3_scl_t};
  assign in_port_20 = ch1_hist_0;
  assign in_port_21 = ch1_hist_1;
  assign in_port_22 = ch2_hist_0;
  assign in_port_23 = ch2_hist_1;
  assign in_port_24 = ch3_hist_0;
  assign in_port_25 = ch3_hist_1;
  assign in_port_26 = packet_count[15:8];
  assign in_port_27 = packet_count[7:0];
  assign in_port_28 = activity_clk_adc;
  assign in_port_30 = activity_phy_tx_clk;
  assign in_port_31 = activity_phy_rx_clk;
  assign in_port_35 = ch1_i_sum;
  assign in_port_36 = ch1_q_sum;
  assign in_port_37 = ch2_i_sum;
  assign in_port_38 = ch2_q_sum;
  assign in_port_39 = ch3_i_sum;
  assign in_port_40 = ch3_q_sum;
  assign in_port_43 = dcm_locked;
  assign in_port_48 = spi_din;

// housekeeping CPU

  cpu _cpu(clk_cpu, clk_cpu_reset,
    uart_tx, uart_rx_r,
    eth_rx_rdata, eth_rx_ready, eth_rx_read, eth_rx_raddr,
    eth_tx_waddr, eth_tx_wdata, eth_tx_we, eth_tx_ready,
    out_port_0, out_port_1, out_port_2, out_port_4, out_port_6, out_port_7,
    out_port_8, out_port_9, out_port_10, out_port_11, out_port_12, out_port_13, out_port_14, out_port_15,
    out_port_17, out_port_18, out_port_19,
    out_port_20,
    out_port_21,
    out_port_22, out_port_23, out_port_24, out_port_25, out_port_26, out_port_27,
    out_port_30,
    out_port_31,
    out_port_40, out_port_41, out_port_42, out_port_43, out_port_44, out_port_45,
    out_port_47,
    in_port_0, in_port_1, in_port_2, in_port_5, in_port_6, in_port_7, in_port_8,
    in_port_17, in_port_18, in_port_19,
    in_port_20, in_port_21, in_port_22, in_port_23, in_port_24, in_port_25,
    in_port_26, in_port_27,
    in_port_28, in_port_30, in_port_31,
    in_port_35, in_port_36, in_port_37, in_port_38, in_port_39, in_port_40,
    in_port_43,
    in_port_48
  );

// monitor the lock-detect signal

  activity _activity(clk_cpu, clock_ftest_ld, led0);

endmodule

module clock_counter(
  input clk,
  output [7:0] c
);

  reg [27:0] p;

  always @(posedge clk)
    p <= p + 1;

  assign c = p[27:20];

endmodule

module gray_to_binary(
  input clk,
  input [7:0] x,
  output reg [7:0] y
);

  reg [7:0] z;

  wire [7:0] xr = {x[0],x[1],x[2],x[3],x[4],x[5],x[6],x[7]};

  always @(*) begin
    z[7] = xr[7];
    z[6] = xr[6]^z[7];
    z[5] = xr[5]^z[6];
    z[4] = xr[4]^z[5];
    z[3] = xr[3]^z[4];
    z[2] = xr[2]^z[3];
    z[1] = xr[1]^z[2];
    z[0] = xr[0]^z[1];
  end

  always @(posedge clk)
    y <= {~z[7],z[6:0]};

endmodule


`include "cpu.v"
`include "uart.v"
`include "picorv32_soc.v"
`include "picorv32.v"
`include "ram.v"
`include "pwm.v"
`include "packet_streamer.v"
`include "crc.v"
`include "activity.v"
`include "quantize.v"
`include "histogram.v"
`include "reset_gen.v"
`include "packet_rx.v"
`include "random.v"
