pmonta/GNSS_Firehose/fpga/firmware/io.c

// output ports

#define PORT_CLOCK             0
#define PORT_LOOPBACK_OUT      1
#define PORT_LED               2
#define PORT_OUT_PHY_SMI       4
#define PORT_OUT_PWM           6
#define PORT_ADC_SPI_OUT      12
#define PORT_FLASH_SPI_OUT    31
#define PORT_I2C              17
#define PORT_STREAMER_ENABLE  21
#define PORT_DC_BASE          22
#define PORT_DCM_RST          30
#define PORT_UART_TX_DATA     32
#define PORT_UART_RX_READ     33
#define PORT_UART_TX_WRITE    34
#define PORT_MAC_ADDR         40
#define PORT_ETH_RX_READ      48
#define PORT_ETH_RX_RADDR     49
#define PORT_ETH_TX_ADDR      50
#define PORT_ETH_TX_DATA      51
#define PORT_ETH_TX_WE        52
#define PORT_ETH_TX_READY     53

// input ports

#define PORT_CLOCK_IN          0
#define PORT_LOOPBACK_IN       1
#define PORT_IN_PHY_SMI        2
#define PORT_ADC_SPI_IN        5
#define PORT_HIST             20
#define PORT_UART_RX_DATA     32
#define PORT_UART_RX_READY    33
#define PORT_UART_TX_READY    34
#define PORT_JIFFIES          44
#define PORT_FLASH_SPI_IN     48
#define PORT_ETH_RX_RDATA     50
#define PORT_ETH_RX_READY     51

#define barrier() asm volatile("" ::: "memory")

int port_read(int p)
{ barrier();
  return (int)(*(volatile unsigned int*)(0x80000000+4*p)); }

void port_write(int p,unsigned int x)
{ barrier();
  (*(volatile unsigned int*)(0x80000000+4*p)) = x; }

void clock_out(int x)
{ port_write(PORT_CLOCK,x); }

void led(int x)
{ port_write(PORT_LED,x); }

void uart_tx_data(int x)
{ port_write(PORT_UART_TX_DATA,x);
  port_write(PORT_UART_TX_WRITE,1);
  port_write(PORT_UART_TX_WRITE,0); }

int uart_tx_ready()
{ return port_read(PORT_UART_TX_READY); }

int uart_rx_data()
{ unsigned int x;
  x = port_read(PORT_UART_RX_DATA);
  port_write(PORT_UART_RX_READ,1);
  port_write(PORT_UART_RX_READ,0);
  return x; }

int uart_rx_ready()
{ return port_read(PORT_UART_RX_READY); }

int eth_rx_data(int addr)
{ unsigned int x;
  port_write(PORT_ETH_RX_RADDR,addr);
  delay_200ns();
  x = port_read(PORT_ETH_RX_RDATA);
  return x; }

unsigned int eth_rx_wdata(int addr)
{ int x0,x1,x2,x3;
  x0 = eth_rx_data(addr);
  x1 = eth_rx_data(addr+1);
  x2 = eth_rx_data(addr+2);
  x3 = eth_rx_data(addr+3);
  return (x0<<24) | (x1<<16) | (x2<<8) | x3; }

void eth_rx_ack()
{ port_write(PORT_ETH_RX_READ,1);
  delay_200ns();
  port_write(PORT_ETH_RX_READ,0); }

int eth_rx_ready()
{ return port_read(PORT_ETH_RX_READY); }

void eth_tx_data(unsigned int addr,unsigned int val)
{ port_write(PORT_ETH_TX_ADDR,addr);
  port_write(PORT_ETH_TX_DATA,val);
  port_write(PORT_ETH_TX_WE,1);
  delay_200ns();
  port_write(PORT_ETH_TX_WE,0); }

void eth_tx_ack(unsigned int tag,unsigned char val)
{ //tag ^= 0x55555555;
  eth_tx_data(0,(tag>>24)&0xff);
  eth_tx_data(1,(tag>>16)&0xff);
  eth_tx_data(2,(tag>>8)&0xff);
  eth_tx_data(3,tag&0xff);
  eth_tx_data(4,val);
  port_write(PORT_ETH_TX_READY,1);
  delay_100us();
  port_write(PORT_ETH_TX_READY,0); }

void eth_tx_ack_word(unsigned int tag,unsigned int wval)
{ //tag ^= 0x55555555;
  eth_tx_data(0,(tag>>24)&0xff);
  eth_tx_data(1,(tag>>16)&0xff);
  eth_tx_data(2,(tag>>8)&0xff);
  eth_tx_data(3,tag&0xff);
  eth_tx_data(4,(wval>>24)&0xff);
  eth_tx_data(5,(wval>>16)&0xff);
  eth_tx_data(6,(wval>>8)&0xff);
  eth_tx_data(7,wval&0xff);
  port_write(PORT_ETH_TX_READY,1);
  delay_100us();
  port_write(PORT_ETH_TX_READY,0); }

unsigned int get_jiffies()
{ return port_read(PORT_JIFFIES); }

void putchar(char c)
{ while (!uart_tx_ready()) {};
  uart_tx_data(c); }

void puts(char* s)
{ char c;
  while ((c=*s++))
    putchar(c); }
