pmonta/GNSS_Firehose/(commit log)

2012-06-03 initial revision
    [board.pcb, bom.xls, firehose_00_overview.sch, firehose_01_ch1.sch, firehose_02_ch2.sch, firehose_03_ch3.sch, firehose_04_ch4.sch, firehose_05_clock.sch]
2012-06-03 include a PDF version of the schematic
2012-07-02 reconfigure the PHY reset signals; give an explicit SYNC signal to the LMK03806
    [board_init.py, chip.ucf, chip.v, hw.py, top.v]
2012-10-21 add skeleton picoblaze code; adjust CPU clock to 62.5 MHz to make timing; UART now at 115200
    [cpu.psm]
2012-10-21 working picoblaze UART demo
    [cpu.psm]
2012-10-21 implement the serial protocol using picoblaze
    [cpu.psm]
2012-10-22 working clock init from picoblaze
    [cpu.psm]
2012-10-22 working PHY initialization code in picoblaze
    [cpu.psm]
2012-10-23 working I2C picoblaze code; board now fully initializes from picoblaze
    [cpu.psm]
2012-10-23 set I2C bus speed to ~100 kbit/s
    [cpu.psm]
2012-10-27 software does AGC at powerup. board is now autonomous
    [cpu.psm]
2012-10-27 initialize all three RF channels; do full gain-control range just in case
    [cpu.psm]
2012-11-08 enclosure, 3D-printable
    [gnss_firehose_bottom.scad, gnss_firehose_bottom.stl, gnss_firehose_top.scad, gnss_firehose_top.stl]
2012-11-08 command-line argument for skipping N packets at start of capture
    [tcpdump_convert_2ch_2bits.c]
2014-04-28 change Ethernet PHY to Micrel KSZ9031RNXCA add TVS diode for DC-input protection use relative paths for footprint files
    [board.pcb, firehose_06_fpga.sch, firehose_07_ethernet.sch, firehose_08_power.sch]
2014-04-28 add footprints for bias tees at RF inputs cosmetic updates to schematic text optional attenuator on 10 MHz input
    [firehose_00_overview.sch, firehose_01_ch1.sch, firehose_02_ch2.sch, firehose_03_ch3.sch, firehose_04_ch4.sch, firehose_05_clock.sch, firehose_06_fpga.sch, firehose_07_ethernet.sch]
2014-04-29 add auxiliary header with FPGA and UART signals change to larger LX9 FPGA add external clock option
    [bom.xls, firehose_01_ch1.sch, firehose_02_ch2.sch, firehose_03_ch3.sch, firehose_04_ch4.sch, firehose_05_clock.sch, firehose_06_fpga.sch]
2014-05-03 add shield clips for optional RF shield cans revise mounting holes
    [firehose_00_overview.sch, firehose_01_ch1.sch, firehose_02_ch2.sch, firehose_03_ch3.sch, firehose_04_ch4.sch, firehose_05_clock.sch, firehose_06_fpga.sch, firehose_07_ethernet.sch]
2014-05-03 better bypassing for clock chip, TCXO ground the DC-input shield
    [firehose_01_ch1.sch, firehose_02_ch2.sch, firehose_03_ch3.sch, firehose_05_clock.sch, firehose_08_power.sch]
2014-05-03 add various test points
    [firehose_01_ch1.sch, firehose_02_ch2.sch, firehose_03_ch3.sch, firehose_05_clock.sch, firehose_06_fpga.sch, firehose_07_ethernet.sch, firehose_08_power.sch]
2014-05-04 switch polarity of UART signals to match 3.3 V logic-level cables such as FTDI's TTL-232R-3V3 series update hw.py to respect 'port' argument
2014-05-04 add lowpass filters on downconverter reference clocks add series resistors on control lines for isolation add series element in the 1.2 V path for current measurement
    [firehose_01_ch1.sch, firehose_02_ch2.sch, firehose_03_ch3.sch, firehose_05_clock.sch, firehose_06_fpga.sch, firehose_07_ethernet.sch, firehose_08_power.sch]
2014-05-04 cosmetic schematic changes
    [firehose_01_ch1.sch, firehose_02_ch2.sch, firehose_03_ch3.sch, firehose_05_clock.sch, firehose_06_fpga.sch, firehose_07_ethernet.sch, firehose_08_power.sch]
2014-05-12 add optional LPF on baseband inputs remap FPGA pins for clean routing to new PHY improve MAX2112 bypassing remove unused refclk wires
    [firehose_01_ch1.sch, firehose_02_ch2.sch, firehose_03_ch3.sch, firehose_04_ch4.sch, firehose_05_clock.sch, firehose_06_fpga.sch]
2014-05-12 export a color PDF of the schematic in the makefile
    [firehose_00_overview.sch]
2014-05-12 revised layout: rough placement preliminary logo
    [board.pcb, logo.pcb]
2014-05-14 separate bypassing for LNA partial placement
    [board.pcb, firehose_01_ch1.sch, firehose_02_ch2.sch, firehose_03_ch3.sch]
2014-05-17 partial routing automate CAM steps (exporting gerbers, BOM, etc.) in the makefile add fiducials
    [board.pcb, firehose_04_ch4.sch, firehose_09_mechanical.sch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]
2014-05-18 more layout add shield clips around TCXO for possibly a better thermal environment logos and revised text
    [board.pcb, firehose_06_fpga.sch, firehose_09_mechanical.sch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]
2014-05-20 layout complete add paste squares in PHY exposed pad
    [board.pcb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]
2014-05-25 HDL and pinout changes for new PHY
    [cpu.psm]
2014-05-28 export PDF with assembly diagram and layer images
2014-05-31 increase scale of PCB check plots and assembly drawings for better readability
2014-05-31 make FPGA mode-bit pullups/pulldowns stronger; 10k was too weak to correctly configure M1
    [firehose_06_fpga.sch]
2014-06-17 send PHY's clk125 to FPGA add clock activity counters and packet counter use an enable for the packet streamer: apparently need to disable packets prior to PHY link up add a PHY reset bit from CPU te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
    [cpu.psm]
2014-06-17 reduce "digital feedback" from ADC outputs back to RF section: change to Gray coding, reverse bit order, reduce drive strength
    [cpu.psm]
2014-06-17 make ADC and MAX2112 clocks the same frequency to reduce spurs; temporary clock plan for just L1
    [cpu.psm]
2014-06-25 add optional correction for ADC's DC offset (just channel 1 for now) reduce 3 dB bandwidth of antialias filter slightly
    [hist.py, hw.py, settings.py, top.v]
2014-06-26 use TCXO as CPU clock
    [firehose_05_clock.sch, firehose_06_fpga.sch]
2014-08-26 small 3D-printable plastic cap for TCXO to reduce air currents
    [tcxo_cap.scad, tcxo_cap.stl]
2014-09-05 reset DCM after configuring clock chip
    [cpu.psm]
2014-09-06 poll PHY for link status; enable packet stream only if link is up (otherwise autonegotiation stalls)
    [cpu.psm]
2014-09-06 close the AGC loop in software; enable by default
    [cpu.psm]
2014-09-06 change default frequency scheme to fref=38.88*62/70, f_l1=46*fref, etc.
    [cpu.psm]
2014-09-10 change to fractional-n synthesis on MAX2112 final band center frequencies for L1, L2, L5
    [cpu.psm]
2014-09-24 add DC correction to RF channels 2 and 3
    [top.v]
2015-03-20 change board size to 4640 x 3900 mil for compatibility with Hammond 1455L1202 enclosure
    [board.pcb]
2015-03-20 adjust ground and power planes
    [board.pcb]
2015-03-22 change SMA jack to panel mount adjust mounting holes and fiducials
    [board.pcb, firehose_01_ch1.sch, firehose_02_ch2.sch, firehose_03_ch3.sch, firehose_04_ch4.sch]
2015-03-23 change Ethernet connector to L829-1J1T-43 (has separate center taps as required by PHY)
    [board.pcb, firehose_05_clock.sch, firehose_07_ethernet.sch]
2015-03-25 change to right-angle LEDs, place along edge
    [board.pcb, firehose_06_fpga.sch, firehose_08_power.sch]
2015-03-26 add reverse-polarity protection
    [board.pcb, firehose_08_power.sch]
2015-03-27 add buffer for TCXO remove external clock header isolation resistors for various control signals
    [board.pcb, firehose_05_clock.sch, firehose_06_fpga.sch, firehose_09_mechanical.sch]
2015-03-27 add current limiters to RF-input bias tees cosmetic: change mislabeled "2_48" mounting holes to the correct "UNC_2_56"
    [board.pcb, firehose_01_ch1.sch, firehose_02_ch2.sch, firehose_03_ch3.sch, firehose_09_mechanical.sch]
2015-04-04 finish PCB place and route swap FPGA pins for PHY_RX_CLK and PHY_NRESET for better on-FPGA clock routing
    [board.pcb, firehose_06_fpga.sch, firehose_09_mechanical.sch]
2015-04-04 produce PCB CAM products (gerbers, board images, xy files, assembly drawings) produce PDF schematic cosmetic silkscreen revisions
    [board.pcb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]
2015-04-04 silkscreen touchups
    [board.pcb]
2015-04-04 new PCB CAM products
    [board.pcb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]
2015-04-10 change TCXO to 38.88 MHz on schematic, symbol, BOM
    [board.pcb, firehose_00_overview.sch, firehose_05_clock.sch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]
2015-04-14 DFM tweaks: modify 0402 footprint
    [board.pcb, firehose_01_ch1.sch, firehose_02_ch2.sch, firehose_03_ch3.sch, firehose_04_ch4.sch, firehose_05_clock.sch, firehose_06_fpga.sch, firehose_07_ethernet.sch]
2015-04-15 DFM tweaks: 0402 component spacing
    [board.pcb]
2015-04-15 DFM tweaks: increase clearance for QFN exposed pads
    [board.pcb]
2015-04-16 DFM tweaks: wire cleanup
    [board.pcb]
2015-04-16 DFM tweaks: fixes from freedfm.com, CAM output
    [board.pcb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]
2015-04-19 DFM tweaks: change vias to 12 mil, enforce 5-mil soldermask dams
    [board.pcb]
2015-04-19 DFM tweaks: add via plugs and primary soldermask clearance around vias (encroachment)
    [board.pcb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]
2015-04-21 add single-page fab and assembly drawings; update BOM
    [bom.xls]
2015-04-22 final annotated BOM
    [bom.xls]
2015-05-07 add internal part numbers to BOM
    [bom.xls]
2015-05-09 fix clock-buffer footprint increase capacitor clearances near the 16-pin and 14-pin headers adjust hole sizes on DC-power connector minor silkscreen adjustments
    [board.pcb, firehose_05_clock.sch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]
2015-05-09 fix copper clearance (found by freedfm.com)
    [board.pcb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]
2015-05-10 minor spacing fixes. final layout
    [board.pcb, bom.xls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]
2015-05-12 at the suggestion of Advanced Circuits, change the QFN pad vias to 10 mil and plug from the bottom surface
    [board.pcb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]
2015-05-26 final BOM tweaks
    [bom.xls]
2015-05-27 minor BOM tweak for Digi-Key order
    [bom.xls]
2015-06-04 fix minor inconsistencies in BOM
    [bom.xls]
2015-06-04 add a CPU command to store into scratchpad registers
    [cpu.psm]
2015-06-04 add panel gerbers from Advanced Circuits
2015-06-04 add some FPGA test environments to help with progressive board bring-up
2015-06-08 revise the plastic TCXO cap
    [tcxo_cap.scad, tcxo_cap.stl]
2015-06-08 restructure the BOM for cleaner interface to octopart BOM tools
    [bom.xls]
2015-06-09 fix TCXO cap orientation
    [tcxo_cap.scad, tcxo_cap.stl]
2015-06-11 support programmable MAC address change Ethernet typelen to 0x88b5 (local experimental use) support flash access over SPI bus for reading MAC address, calibration parameters, serial number, etc.
2015-06-12 support SPI flash reading and programming
2015-06-13 fetch MAC address from flash at power-up
    [cpu.psm]
2015-06-13 SPI support routines
2015-06-19 labels for enclosure front/back/top
2015-06-19 enclosure end plates with apertures
    [end_plate_back.fcstd, end_plate_back.stl, end_plate_front.fcstd, end_plate_front.stl]
2015-06-21 increase clearance on corner holes, remove chamfer
    [end_plate_back.fcstd, end_plate_back.step, end_plate_back.stl, end_plate_front.fcstd, end_plate_front.step, end_plate_front.stl]
2015-06-22 final enclosure artwork and CAD files
    [gnss_firehose_bottom.scad, gnss_firehose_bottom.stl, gnss_firehose_top.scad, gnss_firehose_top.stl]
2015-07-11 Ethernet interface for CPU (write-only for now)
    [cpu.psm]
2017-03-18 start changing over to KiCAD for schematic and PCB layout
    [GNSS_Firehose.kicad_pcb, GNSS_Firehose.sch, firehose_01_ch1.sch]
2017-03-19 more KiCAD schematic
    [GNSS_Firehose.sch, firehose_01_ch1.sch, firehose_02_ch2.sch, firehose_03_ch3.sch, firehose_04_ch4.sch, firehose_05_clock.sch, firehose_06_fpga.sch, firehose_07_ethernet.sch]
2017-03-19 start changeover from picoblaze to risc-v to enable firmware development in C
    [cpu.psm]
2017-03-20 have firmware blink an LED
2017-03-20 fix KiCAD power symbol
    [GNSS_Firehose.sch, firehose_01_ch1.sch, firehose_02_ch2.sch, firehose_03_ch3.sch, firehose_04_ch4.sch, firehose_05_clock.sch, firehose_06_fpga.sch, firehose_07_ethernet.sch]
2017-03-20 schematic, RF channels 2 and 3
    [GNSS_Firehose.sch, firehose_01_ch1.sch, firehose_02_ch2.sch, firehose_03_ch3.sch, firehose_04_ch4.sch, firehose_05_clock.sch, firehose_06_fpga.sch, firehose_07_ethernet.sch]
2017-03-21 more schematic
    [GNSS_Firehose.sch, firehose_01_ch1.sch, firehose_02_ch2.sch, firehose_03_ch3.sch, firehose_04_ch4.sch, firehose_05_clock.sch, firehose_06_fpga.sch, firehose_07_ethernet.sch]
2017-03-26 revert unneeded changes to stock picorv32
    [picorv32.v]
2017-03-27 skip over non-Firehose packets in tcpdump file
    [packet2wav.c]
2017-03-30 more KiCAD schematic: power symbols, global nets
    [firehose_01_ch1.sch, firehose_02_ch2.sch, firehose_03_ch3.sch, firehose_04_ch4.sch, firehose_05_clock.sch, firehose_06_fpga.sch, firehose_07_ethernet.sch, firehose_08_power.sch]
2017-03-30 fix connections
    [firehose_05_clock.sch]
2017-03-31 KiCAD schematic complete
    [firehose_01_ch1.sch, firehose_02_ch2.sch, firehose_03_ch3.sch, firehose_04_ch4.sch, firehose_05_clock.sch, firehose_09_mechanical.sch]
2017-04-01 fix 1.2V power symbol and pin name. Netlists are now identical between gEDA and KiCAD
    [firehose_01_ch1.sch, firehose_02_ch2.sch, firehose_03_ch3.sch, firehose_04_ch4.sch, firehose_05_clock.sch, firehose_06_fpga.sch, firehose_07_ethernet.sch, firehose_08_power.sch]
2017-04-01 start KiCAD layout
    [GNSS_Firehose-B.Cu.gbr, GNSS_Firehose-B.Mask.gbr, GNSS_Firehose-B.Paste.gbr, GNSS_Firehose-B.SilkS.gbr, GNSS_Firehose-Edge.Cuts.gbr, GNSS_Firehose-F.Cu.gbr, GNSS_Firehose-F.Mask.gbr, GNSS_Firehose-F.Paste.gbr]
2017-04-01 footprints and footprint assignments
    [GNSS_Firehose.kicad_pcb, firehose_01_ch1.sch, firehose_02_ch2.sch, firehose_03_ch3.sch, firehose_04_ch4.sch, firehose_05_clock.sch, firehose_06_fpga.sch, firehose_07_ethernet.sch]
2017-04-02 initial placement and wires
    [GNSS_Firehose-B.Cu.gbr, GNSS_Firehose-B.Fab.gbr, GNSS_Firehose-B.Mask.gbr, GNSS_Firehose-B.Paste.gbr, GNSS_Firehose-B.SilkS.gbr, GNSS_Firehose-Edge.Cuts.gbr, GNSS_Firehose-F.Cu.gbr, GNSS_Firehose-F.Fab.gbr]
2017-04-02 fix component rotations and wire endpoints
    [GNSS_Firehose.kicad_pcb]
2017-04-03 footprint and DRC fixes
    [GNSS_Firehose-B.Cu.gbr, GNSS_Firehose-B.Fab.gbr, GNSS_Firehose-B.Mask.gbr, GNSS_Firehose-B.Paste.gbr, GNSS_Firehose-B.SilkS.gbr, GNSS_Firehose-Edge.Cuts.gbr, GNSS_Firehose-F.Cu.gbr, GNSS_Firehose-F.Fab.gbr]
2017-04-03 add power-plane cutouts
    [GNSS_Firehose.kicad_pcb]
2017-04-03 add small polygons
    [GNSS_Firehose.kicad_pcb]
2017-04-04 fix nearly all DRC errors
    [GNSS_Firehose.kicad_pcb]
2017-04-04 place vias
    [GNSS_Firehose.kicad_pcb]
2017-04-04 add thermal vias to footprints
    [GNSS_Firehose.kicad_pcb]
2017-04-05 all nets connected
    [GNSS_Firehose.kicad_pcb]
2017-04-05 layout passes DRC
    [GNSS_Firehose-B.Cu.gbr, GNSS_Firehose-B.Fab.gbr, GNSS_Firehose-B.Mask.gbr, GNSS_Firehose-B.Paste.gbr, GNSS_Firehose-B.SilkS.gbr, GNSS_Firehose-Edge.Cuts.gbr, GNSS_Firehose-F.Cu.gbr, GNSS_Firehose-F.Fab.gbr]
2017-04-05 adjust polygons to be close to former gEDA layout
    [GNSS_Firehose-B.Cu.gbr, GNSS_Firehose-B.Fab.gbr, GNSS_Firehose-B.Mask.gbr, GNSS_Firehose-B.Paste.gbr, GNSS_Firehose-B.SilkS.gbr, GNSS_Firehose-Edge.Cuts.gbr, GNSS_Firehose-F.Cu.gbr, GNSS_Firehose-F.Fab.gbr]
2017-04-06 more adjustments on copper layers
    [GNSS_Firehose.kicad_pcb]
2017-04-06 adjust soldermask features
    [GNSS_Firehose-B.Cu.gbr, GNSS_Firehose-B.Fab.gbr, GNSS_Firehose-B.Mask.gbr, GNSS_Firehose-B.Paste.gbr, GNSS_Firehose-B.SilkS.gbr, GNSS_Firehose-Edge.Cuts.gbr, GNSS_Firehose-F.Cu.gbr, GNSS_Firehose-F.Fab.gbr]
2017-04-06 position text on bottom silkscreen
    [GNSS_Firehose-B.Cu.gbr, GNSS_Firehose-B.Fab.gbr, GNSS_Firehose-B.Mask.gbr, GNSS_Firehose-B.Paste.gbr, GNSS_Firehose-B.SilkS.gbr, GNSS_Firehose-Edge.Cuts.gbr, GNSS_Firehose-F.Cu.gbr, GNSS_Firehose-F.Fab.gbr]
2017-04-07 top silkscreen
2017-04-07 silkscreen descriptive text
    [GNSS_Firehose-B.Cu.gbr, GNSS_Firehose-B.Fab.gbr, GNSS_Firehose-B.Mask.gbr, GNSS_Firehose-B.Paste.gbr, GNSS_Firehose-B.SilkS.gbr, GNSS_Firehose-Edge.Cuts.gbr, GNSS_Firehose-F.Cu.gbr, GNSS_Firehose-F.Fab.gbr]
2017-04-07 add silkscreen logo graphics
2017-04-08 make silkscreen sizes consistent
    [GNSS_Firehose.kicad_pcb]
2017-04-08 postprocess vias to make them "encroached" or "semi-tented"
    [GNSS_Firehose-B.Cu.gbr, GNSS_Firehose-B.Fab.gbr, GNSS_Firehose-B.Mask.gbr, GNSS_Firehose-B.Paste.gbr, GNSS_Firehose-B.SilkS.gbr, GNSS_Firehose-Edge.Cuts.gbr, GNSS_Firehose-F.Cu.gbr, GNSS_Firehose-F.Fab.gbr]
2017-04-10 CAM outputs: position file, BOM
    [GNSS_Firehose-B.Cu.gbr, GNSS_Firehose-B.Fab.gbr, GNSS_Firehose-B.Mask.gbr, GNSS_Firehose-B.Paste.gbr, GNSS_Firehose-B.SilkS.gbr, GNSS_Firehose-Edge.Cuts.gbr, GNSS_Firehose-F.Cu.gbr, GNSS_Firehose-F.Fab.gbr]
2017-04-10 add schematic PDF and BOM
    [GNSS_Firehose_BOM.csv, bom.xls]
2017-04-10 changeover to KiCad complete. Remove gEDA schematic and layout
    [board.pcb, firehose_00_overview.sch, firehose_01_ch1.sch, firehose_02_ch2.sch, firehose_03_ch3.sch, firehose_04_ch4.sch, firehose_05_clock.sch, firehose_06_fpga.sch]
2017-04-10 add page titles to schematic
    [GNSS_Firehose.sch, firehose_05_clock.sch, firehose_06_fpga.sch, firehose_07_ethernet.sch, firehose_08_power.sch, firehose_09_mechanical.sch]
2017-04-14 fix firmware bugs in ADC and downconverter configuration
    [adc.c, max2112.c]
2017-04-19 fix wrong clock on packet tx
    [io.c, top.v]
2017-04-20 rework the polling code for clarity
    [agc.c, cmd.c, ethernet.c, firmware.c]
2017-04-22 fix typo in flash configuration reads
    [flash.c]
2017-05-10 clean up timestamp handling; don't skip starting packets unnecessarily
    [packet2wav_3ch.c]
2019-01-08 increase strength of ADC output drivers. On about 5% of the ADC-->FPGA links there were a few bit errors
    [adc.c]
2024-07-22 uart.v: rename bit to bit1, to avoid confusing SV-compatible parsers (like Verilator)
    [uart.v]
